soumame/namecard/THIRD_PARTY_NOTICES.md

# Third-party notices

このリポジトリで独自に作成したハードウェア設計、製造データ、ファームウェア、Android・iOSアプリ、文書は、ルートの[MIT License](LICENSE)で提供します。

次の第三者著作物には、それぞれのファイルに含まれるライセンスが優先して適用されます。

## STMicroelectronics / Arm CMSIS

- `firmware/Drivers/STM32G0xx_HAL_Driver/` — STMicroelectronics BSD-3-Clause license (`LICENSE.md`)
- `firmware/Drivers/CMSIS/Device/ST/STM32G0xx/` — Apache License 2.0 (`LICENSE.md`)
- `firmware/Drivers/CMSIS/Core/` — Apache License 2.0 (`firmware/Drivers/CMSIS/LICENSE.txt`)

各ディレクトリ内の著作権表示およびライセンス表示を保持してください。

## Google Material Symbols

`client/android/app/src/main/res/drawable/ic_*.xml`のアイコン（独自作成の`ic_qr_code.xml`を除く）はGoogle Material Symbolsを元にしたAndroid Vector Drawableで、Apache License 2.0の対象です。

- Source: <https://github.com/google/material-design-icons>
- License: <https://www.apache.org/licenses/LICENSE-2.0>

## External dependencies

Androidアプリおよびファームウェアのビルド時に取得される外部依存関係は、それぞれの配布元ライセンスに従います。

### ZXing Core

- AndroidのQRコード生成に`com.google.zxing:core:3.5.4`を使用します。
- Source: <https://github.com/zxing/zxing/tree/zxing-3.5.4>
- License: Apache License 2.0。本文はAPK内の`assets/licenses/zxing-core.txt`に同梱します。
