soumame/namecard/firmware/docs/SOURCES.md

# Primary references and vendored components

- Good Display GDEY029T94 product/sample page:
  <https://www.good-display.com/product/386.html>
- GDEY029T94 / SSD1680 specification used for command table and timing:
  <https://www.laskakit.cz/user/related_files/gdey029t94.pdf>
- ST25DV04K datasheet, DS10925:
  <https://www.st.com/resource/en/datasheet/st25dv04k.pdf>
- ST25DVxxK errata ES0616 (FTM 256-byte read and watchdog workarounds):
  <https://www.st.com/resource/en/errata_sheet/es0616-st25dv04k-st25dv16k-and-st25dv64k-device-limitations-stmicroelectronics.pdf>
- AN4913, EH delivery impact during RF communication:
  <https://www.st.com/resource/en/application_note/an4913-energy-harvesting-delivery-impact-on-st25dvi2c-series-behaviour-during-rf-communication-stmicroelectronics.pdf>
- TPS22917 datasheet:
  <https://www.ti.com/lit/ds/symlink/tps22917.pdf>
- STM32G031x6 datasheet (pinout, PVD and BOR electrical characteristics):
  <https://www.st.com/resource/en/datasheet/stm32g031f6.pdf>

Vendored under `Drivers/`:

- STM32G0xx HAL Driver v1.4.7
- CMSIS Device G0 v1.4.5
- CMSIS Core(M) headers: `__CM_CMSIS_VERSION_MAIN=5`, `__CM_CMSIS_VERSION_SUB=3`
  in `Drivers/CMSIS/Core/Include/cmsis_version.h` (the header file revision is V5.0.3).

Each vendor subtree contains its upstream license. Application code in `Core/` is project code.
