soumame/namecard/production/README.md

# Production files

JLCPCBへ入稿するための製造データです。

- [`v5/`](v5/) — Maker Faire Tokyo 2026向けの現行版
- `v2/`〜`v4/` — 過去版の記録。新規発注には使用しないでください
- [`namecard_v5_production.zip`](namecard_v5_production.zip) — `v5/`の配布用パッケージ

発注時は在庫、部品価格、向き、基板プレビューをJLCPCBの画面で再確認してください。製造サービス側の在庫や仕様は変化する可能性があります。
