soumame/namecard/client/ios/README.md

# Namecard for iOS

iOS 17以降向けのSwiftUIアプリです。販売済みの名刺基板・FWを変更せず、
Androidと同じ296×128 BINを利用します。MameCardとしてTestFlightでベータ配布しています。

**[TestFlight事前登録フォーム](https://forms.gle/RqQPmfoJ9aMMtRm66)への回答後に、参加リンクをお送りします。**
届いたリンクからTestFlightの案内に沿ってインストールしてください。試験内容・報告方法は
[ベータ試験ガイド](docs/BETA_TESTING.md)を参照してください。App Store公開に向けた実機検証は継続中です。

以下の機能説明はリポジトリの現行ソースを対象とします。配布済みビルドの変更点はTestFlightの「テスト内容」を確認してください。

## 開発環境

- Xcode 26以降、Swift 6 toolchain（アプリの言語モードはSwift 5）。外部Swiftパッケージは不要です。
- iOS 26では標準のナビゲーションとコントロール、およびエディタの操作面にLiquid Glassを使用します。
  iOS 17〜18では同じ機能と階層を保った標準Material／Buttonスタイルへフォールバックします。
- `Namecard.xcodeproj`を開き、通常は`Namecard` schemeを使用します。
- SimulatorではNFC以外の編集・Library・ファイル機能を確認できます。
- 実機ではApple Developer ProgramのTeamとNear Field Communication Tag Readingを設定します。
  証明書の秘密鍵、プロビジョニングプロファイル、API鍵はリポジトリへ保存しません。

```sh
swift test --package-path client/ios/NamecardCore
python3 client/ios/tools/generate_project.py --check
xcodebuild -project client/ios/Namecard.xcodeproj -scheme Namecard \
  -destination 'generic/platform=iOS Simulator' CODE_SIGNING_ALLOWED=NO build
```

`python3 client/ios/tools/select_simulator.py`でインストール済みiPhoneのUDIDを取得し、
`-destination 'platform=iOS Simulator,id=<UDID>' test`でアプリ単体試験とUI試験を実行します。
文字の代替フォントは言語設定によって変わるため、CIのアプリ単体試験は
`-testLanguage en -testRegion US`を指定します。文字の選択枠を変更した場合は、
`-only-testing:NamecardTests/EditorTests`を英語設定と`-testLanguage ja -testRegion JP`の両方で確認してください。
UI試験はテスト内でアプリを日本語設定で起動します。
XcodeプロジェクトはPython標準ライブラリとmacOSの`plutil`を使う`tools/generate_project.py`から再生成でき、
同期グループによってSwiftファイルが自動的にターゲットへ入ります。
`--check`は書式やXML属性の順序ではなく設定内容を比較します。Team、署名方式・証明書指定・
プロファイル指定、Version／Build（SDK別の指定を含む）は再生成時にも保持します。
Bundle IDや機能フラグ等の変更は生成スクリプト側にも反映してください。

### SDKとSimulator Runtimeの不一致がある場合

インストール済みRuntimeでもschemeの実行先選択が拒否される環境では、最新ソースを
ターゲット指定でビルドし、生成済み成果物からプロジェクトに依存しない`.xctestrun`を作成できます。
`select_simulator.py`が出力する`NAMECARD_SIMULATOR_ID=...`をシェルに設定して実行します。

```sh
xcodebuild -project client/ios/Namecard.xcodeproj -target NamecardTests \
  -configuration Debug -sdk iphonesimulator CODE_SIGNING_ALLOWED=NO \
  SYMROOT=/tmp/namecard-products OBJROOT=/tmp/namecard-objects build
python3 client/ios/tools/make_simulator_test_run.py \
  --products /tmp/namecard-products/Debug-iphonesimulator \
  --output /tmp/namecard-tests.xctestrun
xcodebuild test-without-building -xctestrun /tmp/namecard-tests.xctestrun \
  -destination "platform=iOS Simulator,id=$NAMECARD_SIMULATOR_ID" \
  -parallel-testing-enabled NO
```

UI試験はビルド対象を`NamecardUITests`にし、生成ツールへ`--ui`を追加します。
ツールは選択中のXcodeと実際の`Info.plist`を読み、実行設定だけを生成します。
ビルド・Simulator起動・テスト実行・Runtimeダウンロードは行いません。

`actool`もRuntime不足で失敗する場合、切り分け用のターゲットビルドには
`EXCLUDED_SOURCE_FILE_NAMES=Assets.xcassets`を一時指定できます。その成果物によるテストは、
アセットを含む完全ビルドや配布用Archiveの検証には含めません。SDKに対応するRuntimeを
導入後、除外指定なしで検証してください。

## 機能

- **New:** 画像・日本語テキスト、テキスト追加時のフォント・太字／斜体／下線、移動／サイズ／回転、重なり、Undo／Redo、グリッド・位置スナップ、紙面表示の変換・表示回転スナップ。
- **Library:** 完成BIN保存、取込、名称変更、削除、書き出し、完成画像を1レイヤーとして再編集。
- **Settings:** 白黒クリーニング、10内蔵パターン、STATUS、端末内のコピー可能な通信ログ。
- **振動による位置案内（試作）:** SettingsでONにすると、表示書き込み中の既存ACKから電源・応答の安定を短い振動で案内します。初期OFF。手順とAndroid向けの検討は[触覚案内](docs/HAPTIC_FEEDBACK.md)を参照してください。
- **URL:** HTTP(S)のNDEF書込・URLクリア・読み返し・Mailbox復旧。既知の未フォーマットST25DV04Kにも対応します。
- **QRコード:** URLの隣のボタンから入力フォームを開き、生成プレビューを確認して名刺へ画像として追加できます。
- **BIN:** 白黒4,736 bytes、4階調9,472 bytes。ヘッダーなし、Androidと相互利用可能です。

4階調の作成・保存・BIN入出力は利用できますが、NFC書き込みは無効です。
現FWはEXECUTE後に60秒のRF無通信を要求し、Core NFCのセッション上限に収まりません。
4階調を黙って白黒へ変換しません。Androidで4階調表示した名刺から白黒へ戻す経路も、
独立したFull更新の給電検証が必要なため、現在は拒否します。

## QRコードの作成

Newの`URL`の隣の`QRコード`を押し、URL入力→`QRコードを生成`→プレビュー→`名刺に追加`の順で操作します。
生成画像は通常の画像レイヤーと同様に移動・拡縮・回転・重なり順変更・Undo／Redoでき、
Library・BIN・NFC画像書き込みにも含まれます。QR生成で名刺のNFC URLは変更されません。

HTTP(S)の検証・補完は既存のURL設定と共通です。生成は端末内の
[Core Image QRコード生成器](https://developer.apple.com/documentation/coreimage/ciqrcodegenerator)を利用します。
URL変更時は古いプレビューを消去し、再生成が必要になります。
白い余白を4セル以上確保し、初期配置は最大120×120ピクセル、1セル2ピクセル以上の整数倍率です。
これより細かい長いURLはプレビューのみ可能で、名刺へ追加するには短いURLが必要です。
実物では配置・縮小・回転・余白の重なり・電子ペーパーの状態によって読みやすさが変わるため、書き込み後も読み取れるか確認してください。

## テキストの書式と表示回転スナップ

Newの`テキスト`で文字を入力し、`B`（太字）・`I`（斜体）・`U`（下線）と`フォント`を設定して追加します。
初期値は従来どおりシステムフォント・太字です。フォントは検索でき、入力フォームのプレビュー、
紙面・完成画像・BINで共通の書式を使います。書式は拡縮・回転・Undo／Redoでも保持されます。
フォント一覧は公開APIの[UIFont.familyNames](https://developer.apple.com/documentation/uikit/uifont/familynames)と
`fontNames(forFamilyName:)`から取得するため、OSと端末により異なります。
太字の書体がない場合は、選んだフォントを保ったまま線幅を補います。
斜体は日本語の代替フォントにも反映できるよう、文字全体を傾けます。
そのフォントにない文字はOSの代替フォントで表示されます。

ツールバーの`表示回転スナップ`は、灰色の余白から操作する紙面表示の回転に適用されます。
初期OFFで、ONにすると15°ごとの角度に4°以内で吸着します。既存の要素の位置スナップとは独立しています。
ゆっくり回しても吸着から抜けられ、表示の拡縮・移動と同時に使えます。
表示回転・スナップ設定は完成画像やBINには含まれません。

`要素回転スナップ`は画像・テキストの回転に適用される独立トグルです。初期OFFで、
ONにすると紙面に対する要素の角度を15°間隔・±4°以内で吸着させます。
位置スナップ・表示回転スナップとは別に切り替えられ、移動・拡縮と同時に使用できます。
要素の回転は完成画像・BINにも反映され、1回のジェスチャーをUndo／Redoできます。

## 給電検証と公開制限

通常のDebug／Releaseは`Resources/HardwareValidation.json`に実測結果のある端末・OSだけ
表示書き込みを許可します。初期状態のリストは空です。編集・BIN・URL・STATUSは使用できます。
**テスト通過だけで実測リストを埋めないでください。**

`Namecard Hardware` schemeは実機で給電を測定するための専用ビルドです。
通常／一括／旧FWの更新時間に仮の8／20／8秒を使います。計測値ではありません。
4階調書込と4階調からの移行はこのschemeでも無効です。
上記2つのschemeのArchiveはReleaseを使用します。

`Namecard Beta` schemeをTestFlight試験用に追加しています。最適化したBeta構成でArchiveし、
画面には「ベータ試験版」と表示します。現在はiOS 17以降のNFC対応iPhoneで白黒書き込みを試せます。
時間予算は同じ仮の8／20／8秒で、実測済みとは扱いません。通常Releaseの検証済み端末リストは空のまま維持します。
試験対象の設定と報告内容は[ベータ試験](docs/BETA_TESTING.md)を参照してください。
Betaでも4階調書き込み・未検証の4階調からの移行は無効です。

詳細は[実機試験](docs/HARDWARE_VALIDATION.md)と[配布手順](docs/DISTRIBUTION.md)を参照してください。
自動テスト・Archiveの結果と実機での未確認事項は[検証記録](docs/VALIDATION.md)に記載しています。
PR #4（@fromkk）から取り込んだLibraryサムネイルの改善と、ほかの差分の採用判断は
[選択統合の記録](docs/PR4_INTEGRATION.md)を参照してください。

## 通信と復旧

ST25の通常速度MailboxコマンドをCore NFCの`customCommand`へ渡します。
DATAは128 bytes、ACKは32 bytes。NC v1とCRC、応答の識別・転送位置を検証します。
Mailboxの空き／ACK確認は50ms間隔です。DATAの一時エラー・ACK喪失は、残り時間を確認し、
同じフレームを最大3回（初回を含む）まで送信します。遅れて届いた一致するACKも検証して回収します。
副作用のないMB_CTRL（ST25 AD）読み取りは、一時的なRF応答エラーに限り100／200ms待って最大3回試します。
接続喪失・設定エラーはこの読取再試行の対象外です。Mailboxの内容を消費する読み取りや書き込みには適用しません。
画像転送の起動・COMMIT後は1.5秒、EXECUTE後はFWのquiet指定以上、RFコマンドを止めます。
実測した更新上限＋5秒をセッション内に確保できなければ、EXECUTE前に再スキャンを案内します。

画像とACK進捗はRAMに保持し、同じUIDだけに再開します。アプリ終了後は再度画像を選択します。
START／DATA中の接続喪失では、有効なセッション内で最大6回、同じUIDのタグを再検出します。
元の60秒期限は延長せず、MCUのRAMが失われていれば画像を最初から転送します。
COMMIT以降にはこの再検出を行いません。OSがセッションを終了した場合や復旧回数を使い切った場合は、
画面から同じ名刺を再スキャンしてください。通信ログには端末識別子・OS・コマンド・ACK位置・VDD・残り秒数を残します。
EXECUTE送信後のACK喪失時は、アプリ側から電界を切らずOSのセッション終了を待ちます。
EXECUTE ACKとquiet待機後の完了確認で、一時的な通信エラー・破損フレームが出た場合は、同じ接続でSTATUSだけを
最大3回（初回を含む）確認します。quietと元の更新時間上限・セッション期限を守り、更新命令は追加しません。
接続喪失や位置不一致はこの再試行の対象外です。確認できなければ、表示は更新済みの可能性がある旨と未確認の理由を表示します。
再接続のSTATUS COMPLETEだけでは目的の画像と断定せず、安全に再転送します。
セッション終了時はCore NFCの遅れた応答を待たずにアプリ側の通信処理をキャンセルし、
後から届く応答は破棄します。転送状態の後始末が終わると、画面から再スキャンできます。
終了後は最低1秒、Core NFCが使用中（Code 203）の場合は2／4／6秒の待機を設け、再スキャンの連打を防ぎます。
この待機はアプリ側の対策であり、OSのNFCリソース解放を保証する時間ではありません。
COMMIT応答の喪失後に本体がCHARGING／READYを返した場合、STATUSだけで対象画像を判断せず、
元画像とUIDを保持して新しいTransfer IDでSTARTから清掃付き再転送します。
EXECUTE前に転送位置の矛盾を検出した場合も、次のスキャンに矛盾した再開位置を持ち越しません。

NFCシステムシートの通常の進捗表示は最大毎秒1回とし、段階変更・エラー・完了はすぐ反映します。
アプリの通常進捗は最大毎秒4回です。NFCの画面を独立させ、進捗でエディター・Library全体を再描画しません。
通信ログは引き続き全イベントを記録し、通信中は全文のライブ描画を止めます。コピーでは記録済みの全文を取得できます。

Newの`URL`画面で`URLをクリア`を選び、名刺へタッチすると、URLを空のNDEFレコード
（`TNF_EMPTY`、`D0 00 00`）へ置き換えます。URL入力は不要です。空欄の通常書き込みは
従来どおり拒否します。クリア後は通常タッチで開くURLがなくなり、画像更新とURLの再設定は可能です。
NFCタグ自体の検出やロック設定は変更しません。既存のURL書き込み対応FWをそのまま利用します。
背景読取りはURIレコードを対象とします（[Appleの仕様](https://developer.apple.com/documentation/corenfc/adding-support-for-background-tag-reading)）。

URLの設定・クリアはPREPARE応答後だけMailboxを停止します。URL復旧記録をApplication Supportへ原子的に保存し、
未フォーマット品はCC／長さ0／本体／最終長の順に更新します。
中断後の同じUIDで書き込み予定と一致する場合だけ復旧し、未知データや保護領域は初期化しません。
静的MB_MODE、EH_MODE、パスワード、FW、基板は変更しません。

URL処理は最初に4秒RFコマンドを止め、その後は最大8秒、VCC_ONとMailboxの起動を確認します。
通常の上書きでは全メモリの事前読出しを省き、読み返しはCC／TLVを解析してNDEF末尾までに限定します。
未フォーマット品と初期化途中の復旧では、従来どおり512 bytes全体と保護状態を検証します。
副作用のないURL読出しの一時エラーは100／200ms待って最大3回試します。書込・ACK読出しはその場で再送しません。
接続喪失時は同じUIDを最大3回再検出し、元の60秒期限に14秒を超える余裕がある場合だけ自動復旧します。
再接続時に通常のNDEF領域が既に目的の内容なら再書込を省き、読み返しとMailbox再開を確認して完了します。
URLの処理段階、読出しブロック、一時エラーの再試行、再検出はSettingsの通信ログで確認できます。

クリア中断時も操作の種類とUIDを復旧記録へ保存します。アプリ再起動後はSettingsの
`URLクリアを再開`から同じ名刺で再開できます。未完了のURL設定をクリア操作で置き換えることはできません。
旧バージョンのURL設定の復旧記録も引き続き再開できます。

## 保存とプライバシー

Libraryはアプリ内にBIN＋JSONを保存します。編集レイヤーとUndo／Redo、クリーニング設定は
起動中だけ保持します。LibraryとURL復旧記録はOSバックアップに含まれる場合があります。

振動による位置案内のON／OFFは端末内に保存し、次回起動時にも維持します。
ユーザー操作によるFilesへの書き出し先にはiCloud等も選択できます。
[プライバシーポリシー](docs/PRIVACY.md)を参照してください。
