soumame/namecard/client/ios/docs/PRIVACY.md

# Namecard iOS プライバシーポリシー

Namecardは、名刺基板の画像とURLを編集・書き換えるアプリです。

画像、入力したテキスト、URL、名刺の識別子と通信ログは端末内で処理します。
開発者のサーバーへの送信、広告、利用状況解析、アカウント登録はありません。
写真はシステムの選択画面でユーザーが選んだものだけを読み込みます。

Libraryの完成画像と名称、未完了のURL書き込みを復旧するための記録は、
アプリ内ストレージへ保存します。これらはiOSの端末バックアップに含まれる場合があります。
振動による位置案内のON／OFFも、アプリ専用の設定として端末内へ保存します。
編集中のレイヤー、Undo履歴、画像の転送進捗、通信ログは起動中のメモリで保持します。
Libraryの画像はアプリ内で削除できます。アプリを削除するとアプリ内データも削除されます。

ユーザーがファイルを書き出したり、ログをコピーしたりした場合、選択した保存先・共有先の
サービスへ内容が渡ることがあります。URLには個人情報を含めないよう、共有する内容をご確認ください。
名刺基板へ書き込んだ画像とURLは名刺を持つ人・読み取る人が閲覧できます。

お問い合わせは[プロジェクトのIssues](https://github.com/soumame/namecard/issues)で受け付けます。
公開Issueには個人情報を含む画像・URL・ログを投稿しないでください。
