soumame/namecard/production/v5/namecard_v5_bom.xlsx

Sheet: BOM
Designator | Footprint | Quantity | Value | LCSC Part #
C1, C10, C11, C12, C2, C5, C6, C7, C9 | 0603 | 9 | 1uF 50V X5R | C15849
C3 | 0805 | 1 | 4.7uF 25V X5R | C722528
C4 | 0603 | 1 | 4.7uF 16V X5R | C19666
C13, C8, C47, C18, C20 | 0603 | 5 | 100nF | C14663
C19 | 0603 | 1 | 1nF | C1588
C23, C25 | 0805 | 2 | 1uF | C28323
C24, C26 | 0805 | 2 | 100nF | C28233
C27 | 0402 | 1 | 1nF | C1523
C28, C41, C43, C44, C45 | 0402 | 5 | 100nF | C1525
C29, C30, C31, C32, C42 | 0805 | 5 | 22uF 6.3V X5R | C5674
C40 | 0805 | 1 | 10uF 25V X5R | C5137488
C46, C48, C49, C14, C15, C16, C17, C39 | CP_EIA-3528-21_Kemet-B | 8 | 220uF 6.3V | C30242
D1, D2, D3 | D_SOD-123 | 3 | MBR0530T1G | C82046
D5, D6 | D_SOD-123 | 2 | 1N4148W | C47117477
J1 | Hirose_FH12-24S-0.5SH_1x24-1MP_P0.50mm_Horizontal | 1 | Conn_01x24 | C506794
L1 | L_APV_ANR4020 | 1 | 47uH | C167813
L2 | L_Sunlord_SWPA252012S | 1 | 2.2uH | C23894
Q1 | SOT-23 | 1 | AO3400A | C20917
R1 | 0603 | 1 | 1M | C22935
R2 | 0603 | 1 | 2.2R | C22939
R7 | 0402 | 1 | 4.7M | C3013173
R8 | 0402 | 1 | 1k | C11702
R9 | 0402 | 1 | 36.5k 1% | C25887
R10 | 0402 | 1 | 5.11k 1% (2.5mA) | C274895
R11 | 0402 | 1 | 16.2k 1% | C27176
R12 | 0402 | 1 | 0R | C17168
R13, R4, R6 | 0603 | 3 | 10k | C25804
R14 | 0603 | 1 | 1k EPD DISCHARGE | C21190
U1 | LQFP-32_7x7mm_P0.8mm | 1 | STM32G031K8T6 | C432203
U2 | DFN-8-1EP_3x2mm_P0.5mm_EP1.36x1.46mm | 1 | ST25DV04K-IER6C3 | C2908287
U3, U4 | SOT-23-6 | 2 | TPS22917DBV | C2681320
U5 | SOT-23 | 1 | TPS3839K33DBZR | C96333
U6 | SOT-363_SC-70-6 | 1 | LM66100 | C2869734
U7 | WSON-10-1EP_2.5x2.5mm_P0.5mm_EP1.2x2mm_ThermalVias | 1 | TPS63900 | C1518762

Sheet: Source
Source | JLCPCB purchased-parts export for the 30-board v5 order
Original file | jlcpcb_purchased_parts_30pcs.xls
Original SHA-256 | 9db658aa72fdb9226f612281968298a40f6ec9856aafbc009097e5e60bace6b8
Export date | 2026-09-04
Normalization | Quantity is the number of listed designators per board; purchase quantities and prices remain in the original XLS.
Assembly scope | 69 JLCPCB-assembled placements. J2 is not in the purchased-parts export and is excluded from this BOM/CPL.
JLCPCB format reference | https://jlcpcb.com/help/article/how-to-generate-the-bom-and-centroid-file-from-kicad
