soumame/namecard/client/ios/docs/HARDWARE_VALIDATION.md

# iPhone実機検証

この資料の連続成功・計測条件はApp Store公開用です。TestFlightの協力者向け試験は
[ベータ試験](BETA_TESTING.md)のBeta構成を使い、仮の時間予算と実測結果を分けて扱います。

2026-09-14、URL書き込みでiOSは`isAvailable=false`、Androidは1回で成功したとの報告を受けました。
今回の端末・OS・URL・失敗段階・ログの時刻対応は未取得です。iOSの起動確認、読出し量削減、
一時読出しエラーの再試行、同一UIDの自動再検出を追加しましたが、修正後の実機RF試験は未実施です。
同じURL・同じ名刺で設定→クリア→再設定を確認し、途中切断では別UIDへの書込を拒否し、
再接続後に読み返しとMailbox再開まで完了すること、Settingsに失敗段階が残ることを確認してください。

状態: **転送・再接続が改善し、最新報告では当て方による不調・切断は残るが処理のスタックは見られない。連続書き込みの完了確認警告が解消したかは未確認。給電計測は未実施**。
2026-09-07、ユーザーからアプリのビルド・起動・STATUS表示、その後チェック柄の書き換えが動作したとの報告を受けました。
作成画像は転送の半分より前、毎回異なるバイト位置で止まり、Core NFCの
`NFCError Code=100 "Tag connection lost"`が記録されています。固定の4,096-byte境界での停止ではありません。
通信復旧修正後の再試験では、1回目は約4,000 bytes送信した直後に「送信内容の不一致」とのエラー、
2回目は作成画像の更新に成功したとの報告を受けました。正確な表示文言とACKログは未取得です。
1回目がDATA／COMMIT／EXECUTE後のどの段階だったか、2回目が再開操作か新規書き込みかは未確認です。
追加報告では、失敗時のSettingsログは残っていません。Core NFCコンソールにはCode 100と
`setAlertMessage`の行が繰り返し出ており、ユーザーは切断後も動作を継続できていると確認しています。
このコンソール断片にはNCコマンド・ACK・時刻がないため、再検出の回数やCOMMIT前後の切断とは特定しません。
「書き換え直前に切れると失敗する」という原因の推測は、未確認の仮説として扱います。
その後も複数回書き込みを行い、Code 100が時々発生し、再度操作すると成功することを繰り返したとの報告があります。
URL書き込みとクリーニングも動作確認済みです。URLの初期フォーマット状態、清掃の一括／旧FW方式、
正確な成功・失敗回数、各段階のACKログは未取得です。Androidより転送が遅く感じるとの申告もあり、時間計測は未実施です。
2026-09-08、ユーザーからiPhone XRのOSは**iOS 18**との訂正を受けました。
使用機種はAndroidがPixel 9 Pro／POCO X3 NFC、iOSがiPhone XRです。実機のmodel identifierとOSログは未取得です。
Androidの2機種でも、現在の通信設定で体感3〜4回の切断・復帰を経て成功するとの追加報告があります。
これは正確な再接続回数の計測ではなく、Androidを無切断で成功する基準端末とは扱いません。
両OS、特にAndroidで、ホーム画面へ戻るかアプリを終了するまで再接続できなくなるとの報告もあります。
Androidではその後、正常終了後の次の書き込みで反応しない／URLが開く問題に対して探索再初期化を追加し、
ユーザーから改善したとの報告を受けました（2026-09-08、確認端末・試行回数は未記録）。
iOSの再検出上限6回・キャンセル処理の追加修正後、3試行で失敗したとの報告を受けました。
1回目は約1秒ごとの切断と再試行後、送信完了直後に`isAvailable=false`、再スキャン後は転送位置の不一致で継続不能。
2回目は`ST25 AD NFCError(102) ISO15693=0f`、再スキャン後は同じ不一致、3回目も同様の結果との申告です。
コンソールにはCode 100、Code 203（System resource unavailable）、`setAlertMessage`と
デバッガー接続下の0.52／1.34／1.73秒のHang検出があります。アプリ内TX・ACKログと時刻対応は未取得です。
このため「送信完了」が最終DATA ACK／COMMIT／保存完了のどれだったかはまだ特定できません。
その後の再開不能・レジスタ読取・セッション待機・画面負荷の対策後、ユーザーから
「前回よりはるかによく動作」「切断が原因で中断することなく、復帰もうまくいく」との報告を受けました（2026-09-08）。
ただし連続2回目の書き込みでは、実際の表示更新後に完了確認が未完了というメッセージが出ています。
この報告は切断そのものがなくなったという意味には扱いません。複数の対策を同時に加えたため、改善への寄与も未分離です。
最新のエラー本文・ACK・経過時間・清掃設定・FW識別情報は未取得で、完了応答の喪失か時間不足かは未特定です。
完了確認対策の案内後、さらに「くっつけるとうまく動かなかったり切断されるが、処理がスタックする事態はなさそう」
との報告を受けました。同じ最新ビルドでの試験か、完了確認警告が再発したか、当て方と成功率の対応は未記録です。
実行scheme・ACK本文は未記録です。初期の修正直後は2試行中1成功で、その後の追加試行の正確な回数は不明です。
各経路の10回連続成功は未確認です。この報告だけで表示更新の検証済み端末へ追加しません。
自動テスト・Simulatorで給電成功を証明することはできません。
販売済みと同じ基板／FW／EPD／接着材／カバーを使用し、FWを書き換えずに試験します。

## 使用端末と公開資料で分かる範囲

| 端末（ユーザー申告） | 公開資料・現実装で確認できること | 実測・確認が残ること |
|---|---|---|
| Pixel 9 Pro | GoogleがNFC搭載とNFC位置の図を公開。公開caiman設定はSTのNFCサービスを使用。Android版はNfcVを使用 | NFC ICの正確な型番・実端末のOS・maxTransceiveLength・DATAサイズ・VDD・成功率 |
| POCO X3 NFC | Xiaomi公式仕様にNFC搭載を明記。Android版は同じNfcVのコード経路を使用 | NFC ICの正確な型番・最適固定位置・OS・実DATAサイズ・VDD・成功率 |
| iPhone XR（iOS 18との訂正申告） | Apple公式仕様でNFC reader mode対応。iFixitの実分解ではNXP SN100Vを同定。iOS版はCore NFCを使用 | 名刺へ供給できる電力・最適位置・転送時間・成功率 |

資料: [Pixelの仕様](https://support.google.com/pixelphone/answer/7158570?hl=en)、
[PixelのNFC位置図](https://support.google.com/pixelphone/answer/7157629?hl=en)、
[POCO X3 NFCの仕様](https://www.po.co/global/poco-x3-nfc/specs/)、
[iPhone XRの仕様](https://support.apple.com/en-ie/111868)、
[iFixitのXR実分解](https://www.ifixit.com/Teardown/iPhone%2BXR%2BTeardown/114123)。
Pixel 9 Proとcaimanの対応は[Googleのドライバー一覧](https://developers.google.com/android/drivers#caiman)で確認し、
STサービスは[Google公開の端末設定](https://android.googlesource.com/device/google/caimito/%2B/refs/tags/android-platform-15.0.0_r4/device-caiman.mk)で確認しています。
ソフトウェア構成からNFC ICの厳密な型番や名刺への出力を断定しません。

STの[AN5233](https://www.st.com/resource/en/application_note/dm00545186-energy-harvesting-with-st25dvi2c-series-dynamic-nfc-tags-stmicroelectronics.pdf)は、
スマートフォンのNFCコントローラー、アンテナの大きさ・位置・距離が取得できる電力に影響すると説明しています。
NFC搭載の有無やCPU世代だけで、この名刺に対する給電能力を順位付けしません。
3機種の比較ではアプリ側のDATA長と待機設定の差もあるため、今回の結果をそのままハードウェア性能差と扱いません。

## 記録する条件

- iPhone製品名、hardware model identifier、OSバージョン、ケースと固定位置。
- 基板版、出荷FWの識別情報、受信capability、パネル／カバー構成。
- セッション開始から検出、COMMIT、READY、EXECUTE ACK、COMPLETEまでの時刻。
- 無通信時の電界維持時間、OSのセッション失効、SYS_VDDとEPD_SW波形、最低VDD。
- 正常更新／一括クリーニング／旧FWクリーニングのEXECUTE以降の最大所要時間。

ST25DV04K→LM66100→TPS63900→VRES→SYS_VDDで給電します。現行回路図のVRESは約1.65mFです。
`simulation`の旧容量による表は検証結果として使用しません。
充電目標3.20V、EPD更新開始2.80V以上を確認します。
測定・外部電源は既存のfirmware/docs/HARDWARE_GATE.mdの手順に従ってください。

## 試験表

下表の各公開対象を、最小対応OS機と現行OS機を含む2機種以上で各10回連続成功させます。
対応しない経路を成功扱いにせず、プロファイルでは無効のままにします。

| 操作 | 結果 | 確認内容 |
|---|---|---|
| STATUS | 表示まで確認（ユーザー申告、2026-09-07） | ACK本文、VDD、FW error、capability、UID、機種・OS・試行回数の記録は未取得 |
| 作成画像（清掃設定未確認） | 修正後の1回目は約4,000 bytes後に不一致エラー、2回目は更新成功（ユーザー申告） | 清掃設定、正確なエラー、最後のACK、操作が新規か再開か |
| 作成画像の繰り返し書き込み | 最新修正後は転送・復帰が改善。連続2回目は表示更新済みだが完了確認が未完了 | 最終STATUS・EXECUTE ACK、残り時間、清掃設定、成功率 |
| クリーニング（方式未確認） | 動作確認済み（ユーザー申告） | 一括／旧FW方式、最後の画像、最低VDD、時間 |
| 白黒・清掃OFF | 清掃OFFと特定できる記録は未取得 | 本画像、ゴースト、最低VDD、COMPLETE |
| 白黒・FW一括清掃 | 一括清掃と特定できる記録は未取得 | 白→黒→白→本画像、再充電、時間上限 |
| 旧FWの清掃 | 未実施 | PATTERN4→3→4→画像、セッションまたぎ |
| 10内蔵パターン | チェック柄のみ更新成功報告。10種・連続試験は未実施 | 単独と連続、完了番号から再開 |
| DATA中の切断 | 最新修正後は切断による中断がなく復帰できるとの報告。回数と処理経路はログ未確認 | MCU保持／電源断、重複ACK・STARTから再送 |
| Flash保存後の切断 | 未実施 | PREPAREDから回復、以前のCOMPLETEを誤認しない |
| EXECUTE前後の切断 | 未実施 | ACK喪失、途中更新から同じ画像へ回復 |
| 時間不足・アプリ背景化 | 未実施 | 新セッションでの再開、更新中に自発的な時間切断をしない |
| URL既存／工場初期状態 | URL書き込みの動作確認済み。初期状態は未確認 | 書込・raw読み返し・Mailbox再開・通常タッチでURL |
| URL中断・再起動 | 未実施 | 同じUIDの復旧、未知変更の拒否、URL後の画像転送 |
| URLクリア | 未実施 | URL設定→クリア→通常タッチでURLが開かない→画像更新→URL再設定。Android／iOS双方で確認 |
| URLクリア中断・再起動 | 未実施 | クリア中の切断後に同じUIDで復旧。iOSはアプリ再起動後もSettingsから再開。クリア済み名刺の再クリアも確認 |
| QRコード画像 | 未実施 | QR生成→名刺へ追加→画像書き込み→Android／iPhoneのカメラで元URLを開けること。再配置・Library再読込後も確認 |
| AndroidとBIN往復 | 未実施 | 同一BINを両クライアントで表示・書込 |
| 4階調表示／pending→白黒・PATTERN | 未実施・無効 | Full白更新を含む電力・時間・中断復旧の独立検証 |

4階調移行は現ビルドで無効です。計測用に有効化するときだけ、TransferCoordinatorへ明示的な
grayTransitionRefreshSecondsを設定し、初版の公開プロファイルへ自動追加しないでください。
4階調そのもののNFC書き込みは今回の公開範囲に含めません。

## DATA転送の接続喪失を再試験する手順

1. `Namecard Hardware` schemeで最新コードを実機へ入れ、Settingsの通信ログを消去します。
2. 同じ白黒画像を選び、iPhone上端と名刺のアンテナの位置を固定して書き込みます。
   清掃ON／OFF、ケースの有無、固定位置も記録します。画像の絵柄を小さくしてもBINは4,736 bytesのままです。
3. 成否にかかわらずSettingsのログを保存します。端末・OS、最後のACK位置、VDD／最低VDD、
   失敗したST25コマンドとエラー、残り時間、DATA再送／UID再検出の有無を確認します。
4. 接続が取り直された場合は、同じ画像を最後まで更新できるか、RAM喪失後にSTARTから再送されるかを確認します。
   再検出後も元の60秒期限を守り、COMMIT以降や表示更新中に再検出しないことを確認します。
5. DATA中に3〜4回の切断・復帰を試し、ホーム画面への移動やアプリ終了なしで継続できるか確認します。
   iOSでセッションが終了した場合は、アプリの再開操作で新しいNFCシートを開けるか確認します。
   AndroidはReader Mode再初期化後に検出できるか、復旧中にURLから別アプリが開かないかも確認します。

修正ではDATAの限定的な再送、50msのMailbox確認間隔、START／DATA中だけのUID再検出を追加しました。
修正後に画像更新は成功していますが、安定性の検証と不一致エラーの原因特定は未完了です。Code 100だけで給電不足と断定せず、
ST25のRF／I2C競合も候補として、ACKログと電圧波形を照合してください。
[STの同種エラーに関する説明](https://community.st.com/t5/st25-nfc-rfid-tags-and-readers/how-to-realize-gt-gt-poll-lt-lt-cycle-as-described-in-an4910-in/td-p/606400)、
[AppleのrestartPolling仕様](https://developer.apple.com/documentation/corenfc/nfctagreadersession/restartpolling())を参照しています。

2026-09-08の追加修正では、iOSの同一セッション内の再検出上限を2回から6回へ増やしました。
Core NFCの接続開始時の接続喪失も復旧対象とし、セッション終了後は遅れたSDK応答を待たずに
アプリ側の処理をキャンセルします。元の60秒期限、同一UID、START／DATA限定の条件は維持しています。
Androidでは古い接続・転送処理が終了した後にReader Modeを300msの間隔で停止・再開し、
URL用接続を含むキャンセル処理と古い検出通知の排除を追加しました。
Androidは後続の連続書き込み修正後に改善報告を受けています。
iOSの実機では上記の再開不能が再発し、追加の調査・修正を行いました。

## 再開不能・Code 102／203・画面負荷の追加対策（2026-09-08）

FWの`app.c`ではpending画像をFlashから復元する際にID・次sequenceを復元しますが、
`nc_protocol.c`の重複フレーム判定用キャッシュは復元しません。
COMMIT受信後にACKを失い、その後に再起動した場合を模擬すると、修正前のiOSでも
転送位置の不一致を再現できました。実機の3試行すべてがこの経路だったとはまだ断定しません。

- COMMIT未確認のままCHARGING／READYへ再接続したら、保持した画像を新しいIDでSTARTから清掃付きで再送します。
- EXECUTE前の矛盾した再開位置は破棄し、元画像とUIDを保持します。ACK検証を緩めたり、STATUSだけで完了にはしません。
- ST25 ADの副作用のないレジスタ読み取りだけ、一時エラー時に100／200ms待って再試行します（最大3回）。
- 終了後に最低1秒、Code 203時は2／4／6秒待ち、終了処理と待機が終わるまで再開ボタンを出しません。
  OSのリソース解放を保証する時間ではなく、連打による再開始要求を抑えるアプリ側の設定です。
- システムシートの通常進捗を毎秒1回、アプリ進捗を毎秒4回までに抑えます。通信ログの全文描画を通信中は止め、
  NFC表示の更新がエディター・Library全体へ伝わらないようViewを分離しました。ログの記録・コピーは継続します。

[AppleのSystemIsBusyの説明](https://developer.apple.com/documentation/corenfc/nfcreadererror-swift.struct/code/readersessioninvalidationerrorsystemisbusy)、
[応答性改善の指針](https://developer.apple.com/documentation/xcode/improving-app-responsiveness)も参照しました。
Hang行だけからNFC切断の原因とは決めつけず、必要なら実機InstrumentsでMain Threadの停止箇所を確認します。
追加修正後、転送・復帰の改善報告を受けました。毎秒の切断の有無や各対策の寄与はログで分けて評価します。

「FW応答の転送位置が送信内容と一致しません」というアプリの文言は、
`TransferError.inconsistentAcknowledgement`です。コマンドとの対応、復旧時のsequence／offset、
表示更新後のSTATUSの位置・状態を確認する複数箇所で使われています。
この文言だけで本体の再起動や画像CRC不一致とは判定できません。
次回は失敗前後のTX・ACKと成功時のログを保存し、整合性の検証条件は緩めずに原因を確認します。

## 表示更新後の完了確認（2026-09-08）

連続2回目の画像更新後にSTATUSの応答だけを失う模擬試験で、修正前の処理が完了確認を打ち切ることを再現しました。
これは実機で報告された最後のエラー原因を特定したものではありません。

- EXECUTE応答とquiet待機の後、STATUSの一時的な通信エラー・破損フレームは、同じ接続で最大3回（初回を含む）確認します。
- 再試行の前にもquiet指定を守り、元の更新時間上限とセッション期限に余裕がある場合だけ続けます。
- 実際の接続喪失・キャンセル・位置不一致はこの再試行の対象外です。更新命令の再送・タグ再検出・ACK検証の緩和は行いません。
- 確認できない場合は「表示は更新済みの可能性がありますが、完了応答を確認できません」と表示し、電界を意図的に切りません。
  Settingsには転送ID・EXECUTE応答の有無・最後のACK位置・quiet・残り秒数を記録します。

追加報告ではスタックは見られませんが、完了確認の修正自体の成否は未確認です。まず画像A→Bの連続2回で表示とアプリの完了表示を照合し、
確認保留が出た場合はNFCシート終了後にSettingsログの末尾を保存してください。

## 次に確認する順序

触覚案内の初回試作は書き込み中に振動しないとの報告を受けました。原因ログは未取得です。
Core Hapticsへの変更後、ユーザーから書き換え・振動とも正しく動作したとの報告を受けました。
試行回数・OFF／ONの時間比較・電圧ログは未取得で、公開条件の達成とは扱いません。初期OFFを維持します。
テキスト操作時などの約3秒のHangも報告され、[計測を追加して切り分け中](PERFORMANCE.md)です。
試す場合は[触覚案内の手順](HAPTIC_FEEDBACK.md)に従い、OFF／ONの成否と所要時間を分けて記録してください。

先に当て方を比較します。同じ名刺・画像・清掃設定で位置を少しずつ変え、候補2〜3か所を各3回試します。
試行中は位置を動かさず、ケース・向き・位置を記録します。安定する位置を決めてから以下の連続試験へ進みます。
接触させること自体を最適な条件とは仮定せず、配置による差とアプリの復旧可否を分けて記録します。

1. 見分けやすい白黒画像A／Bを交互に書き込み、まず清掃OFFで10回、続いて清掃ONで10回試します。
   毎回、アプリの完了表示と電子ペーパーの最新画像の両方を確認します。
   以前の画像が残ったまま完了扱いになっていないこと、清掃途中の白／黒で止まらないことを確認します。
2. 試行ごとに画像、清掃設定、成否、所要時間、自動復旧の有無、手動の再スキャン回数を記録し、
   成功時もSettingsのログをコピーします。手動でやり直した成功は、最初の試行の失敗と分けて記録します。
3. 通常書き込みが安定したら、DATA途中と「4,736 bytes送信後・充電中」に位置を外し、同じ名刺で再開を試します。
   最後まで新しい画像になるかを確認します。最初の確認では表示更新開始後は位置を保ちます。
   EXECUTE中の電源断復旧は、上記の基本経路を確認した後、試験表の独立した項目として実施します。
4. URL設定→画像更新→通常タッチで同じURLを開く流れを確認します。
   別の名刺がある場合は、中断した画像の再開時に別UIDを拒否することも確認します。
5. Androidで出力した白黒BINもiOSで書き込み、2機種目のiPhoneで同じ公開対象経路を確認します。
   4階調関連の無効設定は維持します。

4,736 bytesの送信完了後にも、画像検証・保存、充電、EXECUTE、表示更新、完了確認が残ります。
アプリのバイト数だけを成功判定に使いません。

## Androidとの速度比較（実コードの設定差）

| 項目 | iOS | Android |
|---|---|---|
| DATAペイロード | 初版計画どおり128 bytes固定 | `min(240, maxTransceiveLength - 28)` bytes |
| 白黒4,736 bytesのDATA回数（再送除外） | 37回 | 240 bytesで送れる端末なら20回 |
| 送信後の最初のACK確認まで | 50ms | 50ms |
| ACKがまだない場合の確認間隔 | 50ms | 15ms |
| Mailboxが空くまでの確認間隔 | 50ms | 10ms |
| VDDに応じたDATA間隔 | 50／200／500ms | 同じ閾値・間隔 |

iOSの128 bytesはアプリ側の選択であり、Core NFCの最大ペイロードを表すものではありません。
初期計画に固定値として入れた暫定設定で、3機種の仕様や128／240 bytesの比較試験を根拠にした選定記録はありません。
小さいフレームから初期検証する選択ではありますが、128 bytesの方が安定するという実測根拠は未取得です。
本体のMailboxは256 bytes、NCヘッダーは16 bytesなので、FWプロトコルのDATA上限は240 bytesです。
128 bytesを給電の安全基準やMCUのRAM上限と説明しません。送信回数が増えてセッションが長くなる不利益も評価します。
送信回数が増える分、ACK待ちと給電のための間隔も繰り返します。VDDが低い場合は各回の待ちが長くなり、
一時エラーの再送・再検出・RAM消失によるSTARTからの再送でさらに所要時間が延びます。
ACKが最初の確認で届いていれば、確認間隔50msと15msの差による追加待ちはありません。
設定差から遅くなる要因は確認できますが、実際の速度比と各要因の寄与は未計測です。

比較は同じ白黒BIN・同じ清掃設定で、STARTから最終DATA ACK、COMMITからREADY、EXECUTEからCOMPLETEを分けて測ります。
Androidの実DATAサイズ、両端末のVDD、自動復旧と手動やり直しも記録します。
Androidの上限は実際の[getMaxTransceiveLength()](https://developer.android.com/reference/android/nfc/tech/NfcV#getMaxTransceiveLength())で取得し、
既存ログの`maxTx`と`DATA payload`で確認します。Pixel／POCOがともに240 bytesだったとはまだ確定していません。
今回の比較では通信設定を変更していません。将来DATAサイズを増やす試験では、変更前後の成功率も比較し、
128-byte境界を前提にした再開処理・テストも合わせて見直します。FWのquiet指定や給電待機を速度だけのために短縮しません。

## 実測値の反映

測定完了後、レポートをこのディレクトリへ追加してHardwareValidation.jsonのdevicesへ
model、iOSMajor、evidence（client/iosからのレポート相対パス）、normalSeconds、
batchSeconds、legacySeconds、completedRunsを記録します。時間にはばらつきを含む実測上限を使います。
未検証の一括／旧FW経路は対応する値をnullにし、その経路だけ無効のままにします。
5秒の余裕はアプリが別途加えます。時間を収めるためにquiet指定を短縮しません。

```sh
python3 client/ios/tools/check_release_readiness.py
```

現時点では検証記録がないため、このチェックは意図どおり失敗します。
