soumame/namecard/snapshots/namecard_revb-konnect-final-verified_1786166593.pdf

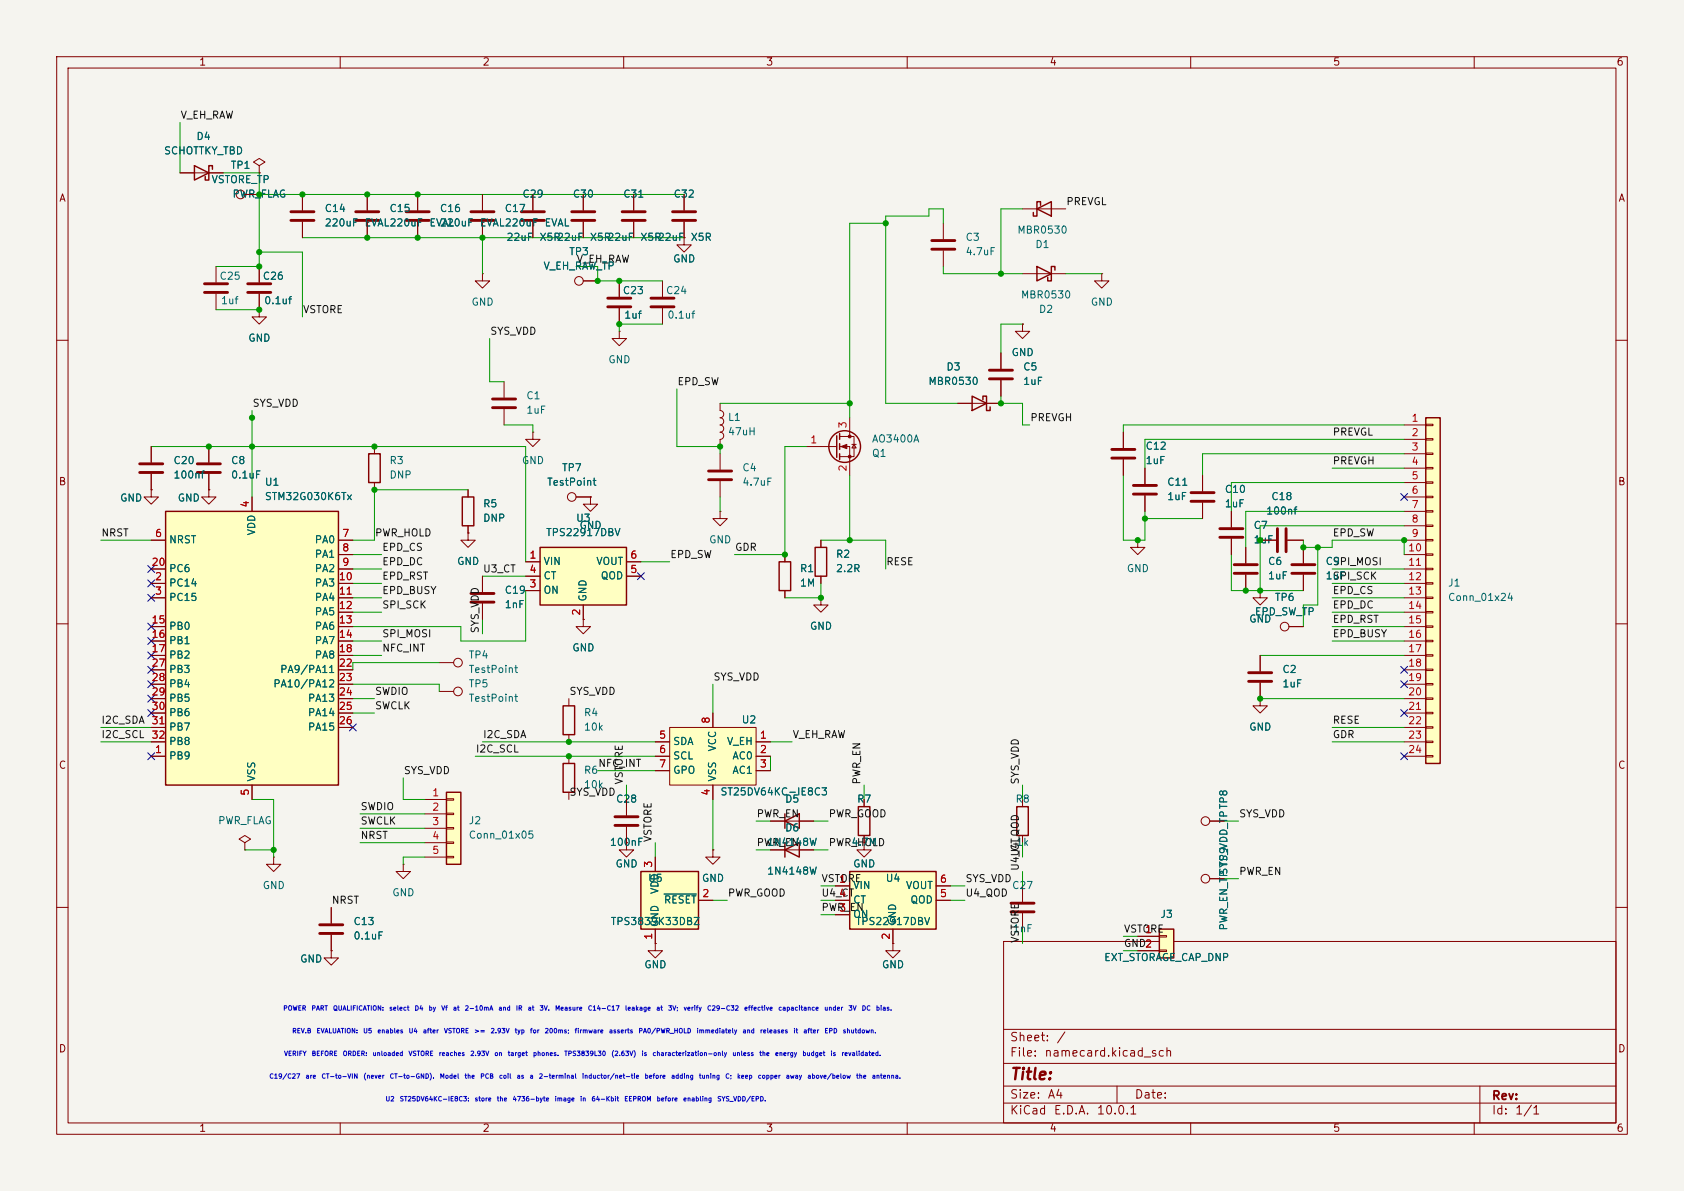
[picture p1: page 1]

Size: A4 | Rev:
KiCad E.D.A. 10.0.1 | Id: 1/1
