soumame/namecard/snapshots/namecard_revb-konnect-verified_1786166523.pdf

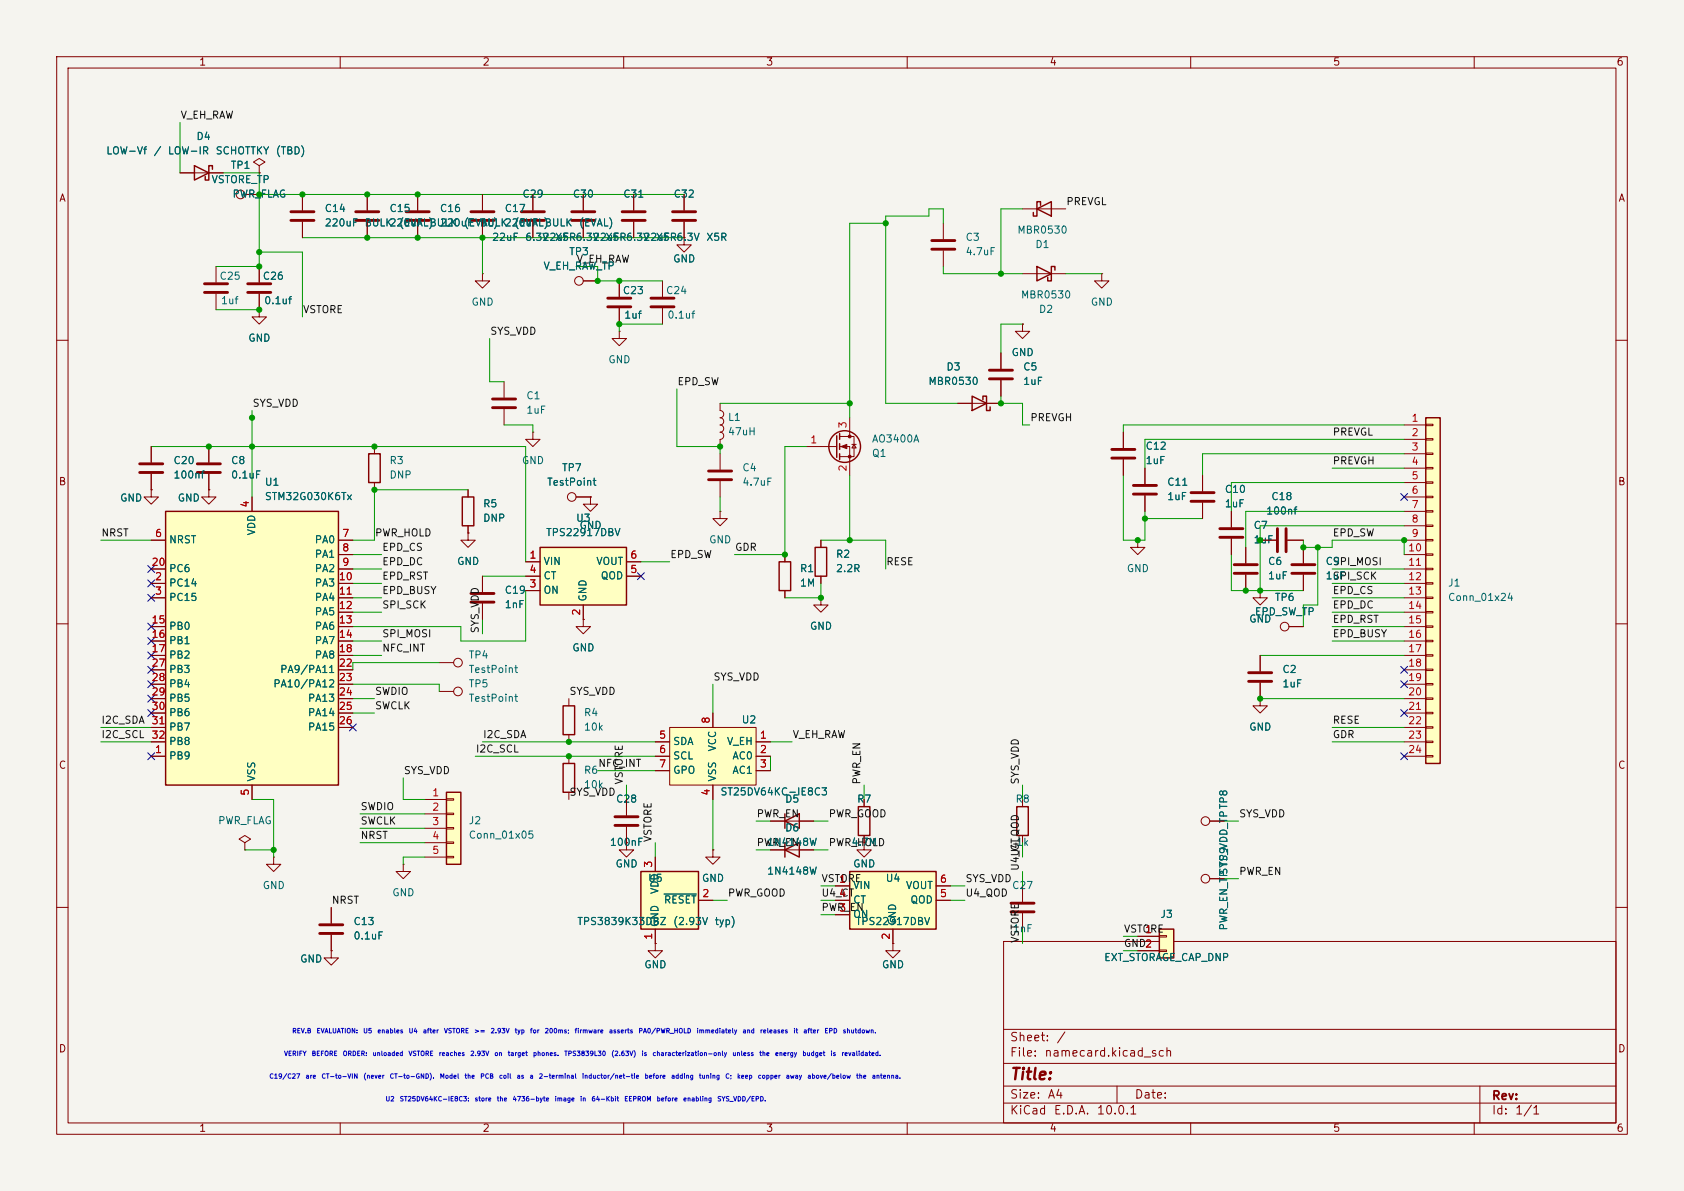
[picture p2: page 1]

LOW-Vf / LOW-IR SCHOTTKY (TBD) TP1

Size: A4 | Rev:
KiCad E.D.A. 10.0.1 | Id: 1/1
