soumame/namecard/snapshots/namecard_pcb_tps63900_added.pdf

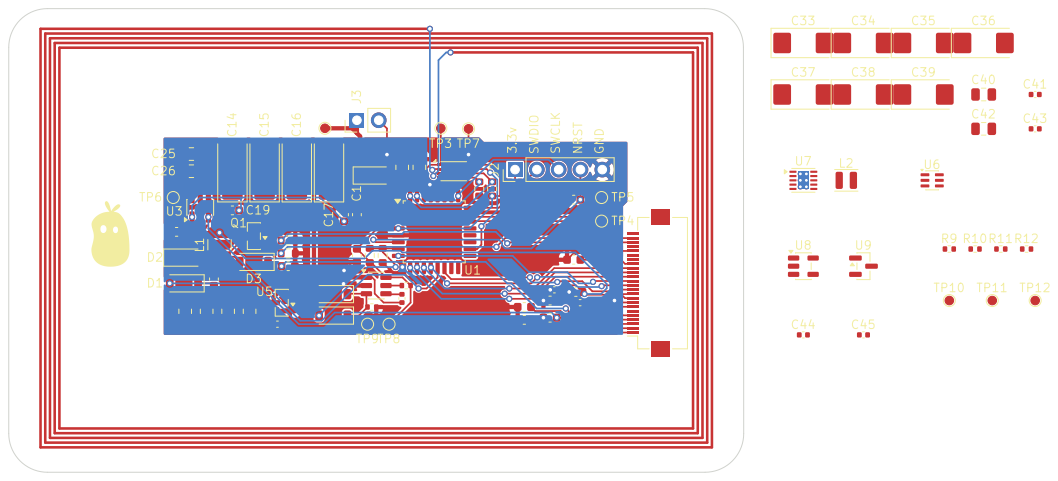
[picture p3: page 1]

3.3v SWDIO SWCLK NRST GND TP3 C34 C40 C41 C15 R10 C45 D1 C14
