soumame/namecard/snapshots/namecard_pre-revb-konnect_1786165618.pdf

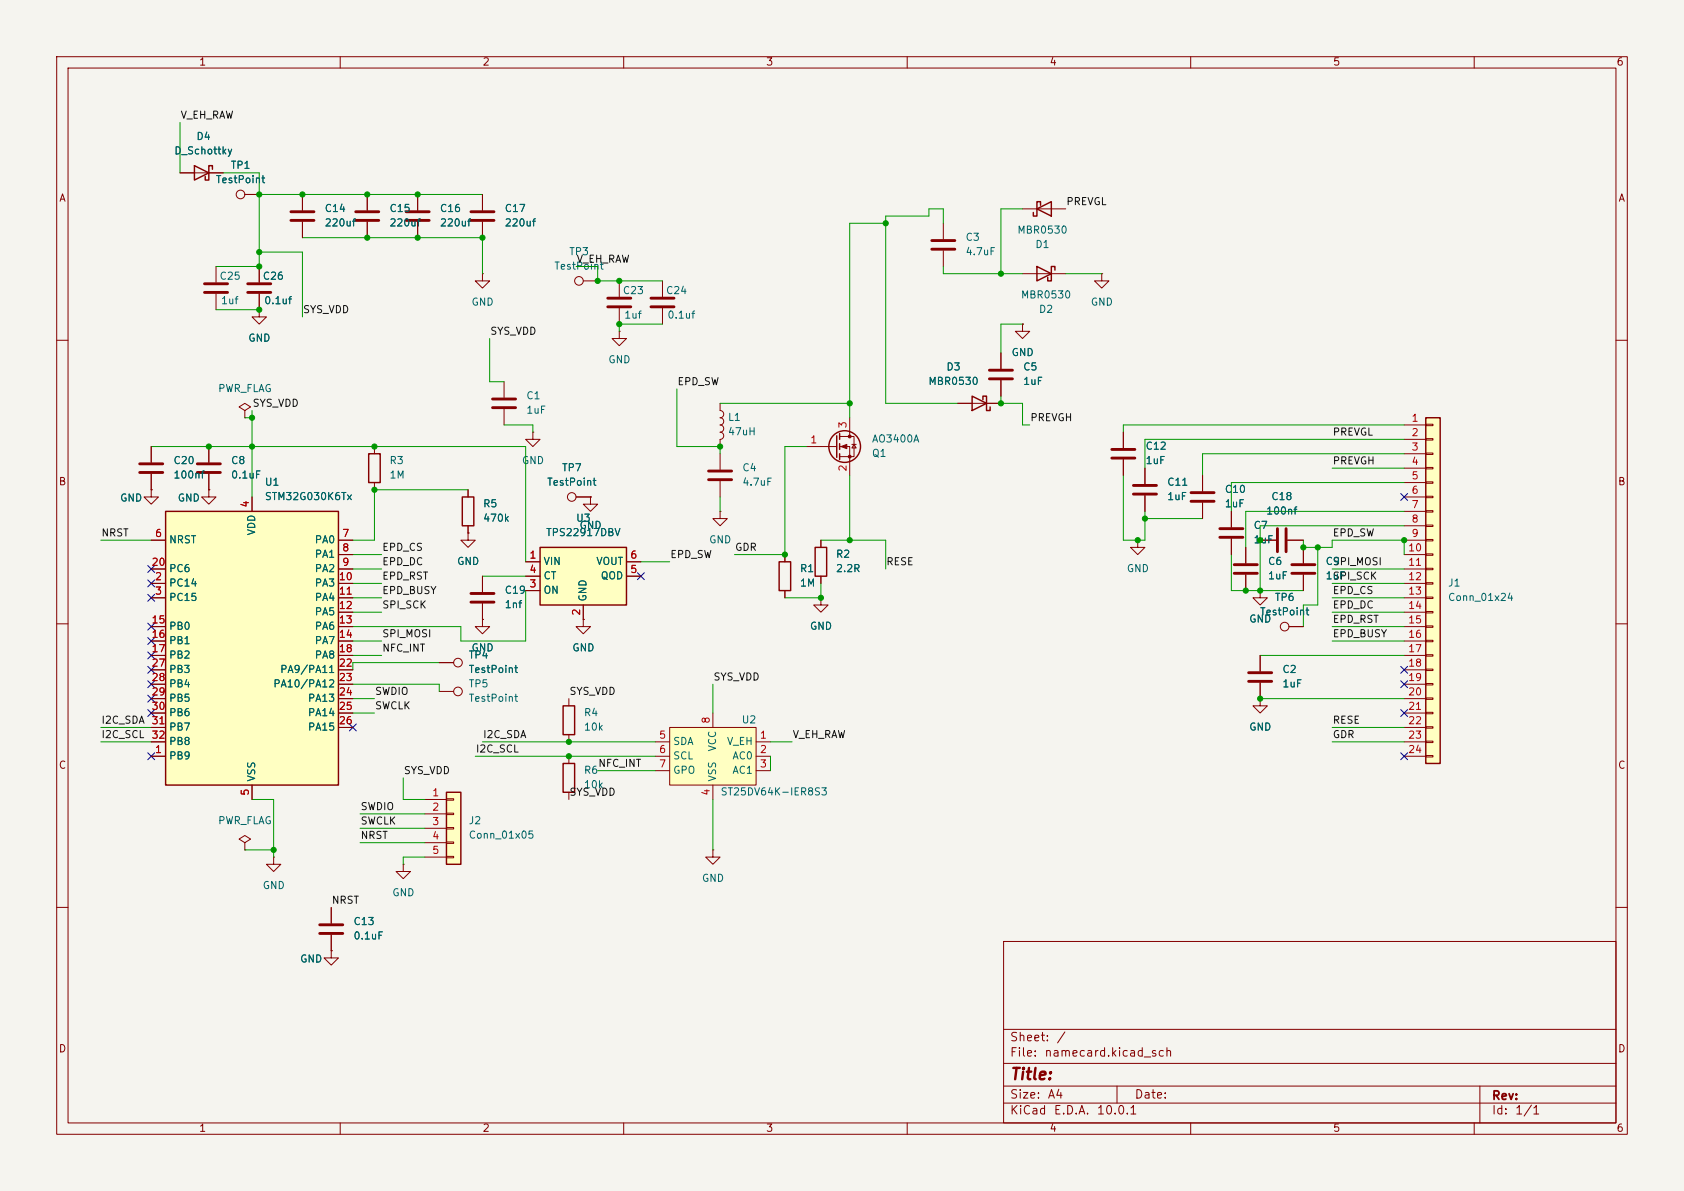
[picture p4: page 1]

Size: A4 | Rev:
KiCad E.D.A. 10.0.1 | Id: 1/1
