soumame/namecard/snapshots/namecard_pre_tps63900_1786407801.pdf

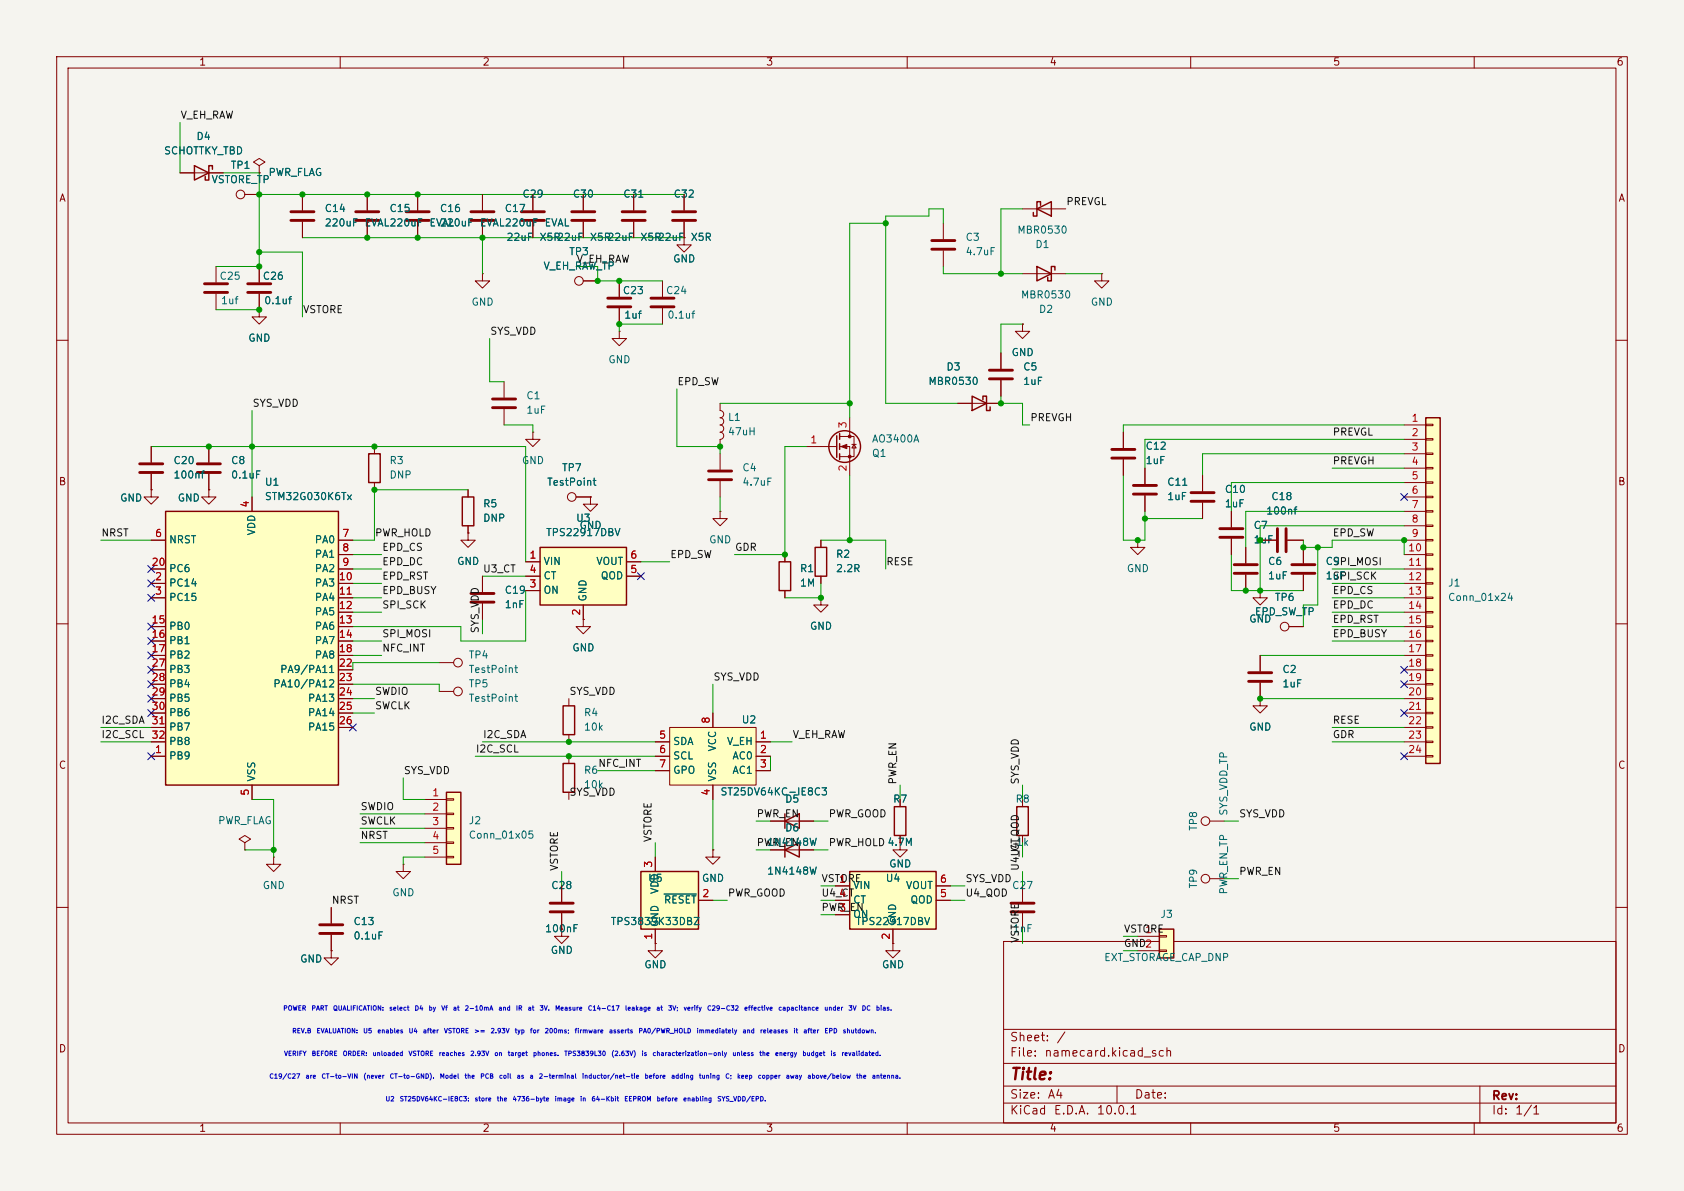
[picture p5: page 1]

POWER PART QUALIFICATION: select D4 by Vf at 2-10mA and IR at 3V. Measure C14-C17 leakage at 3V; verify C29-C32 effective capacitance under 3V DC bias. REV.B EVALUATION: U5 enables U4 after VSTORE >= 2.93V typ for 200ms; firmware asserts PA0/PWR_HOLD immediately and releases it after EPD shutdown. U2 ST25DV64KC-IE8C3: store the 4736-byte image in 64-Kbit EEPROM before enabling SYS_VDD/EPD. VERIFY BEFORE ORDER: unloaded VSTORE reaches 2.93V on target phones. TPS3839L30 (2.63V) is characterization-only unless the energy budget is revalidated. C19/C27 are CT-to-VIN (never CT-to-GND). Model the PCB coil as a 2-terminal inductor/net-tie before adding tuning C; keep copper away above/below the antenna. C13
0.1uF GND

Size: A4 | Rev:
KiCad E.D.A. 10.0.1 | Id: 1/1
