soumame/namecard/snapshots/namecard_revb-konnect-final_1786166376.pdf

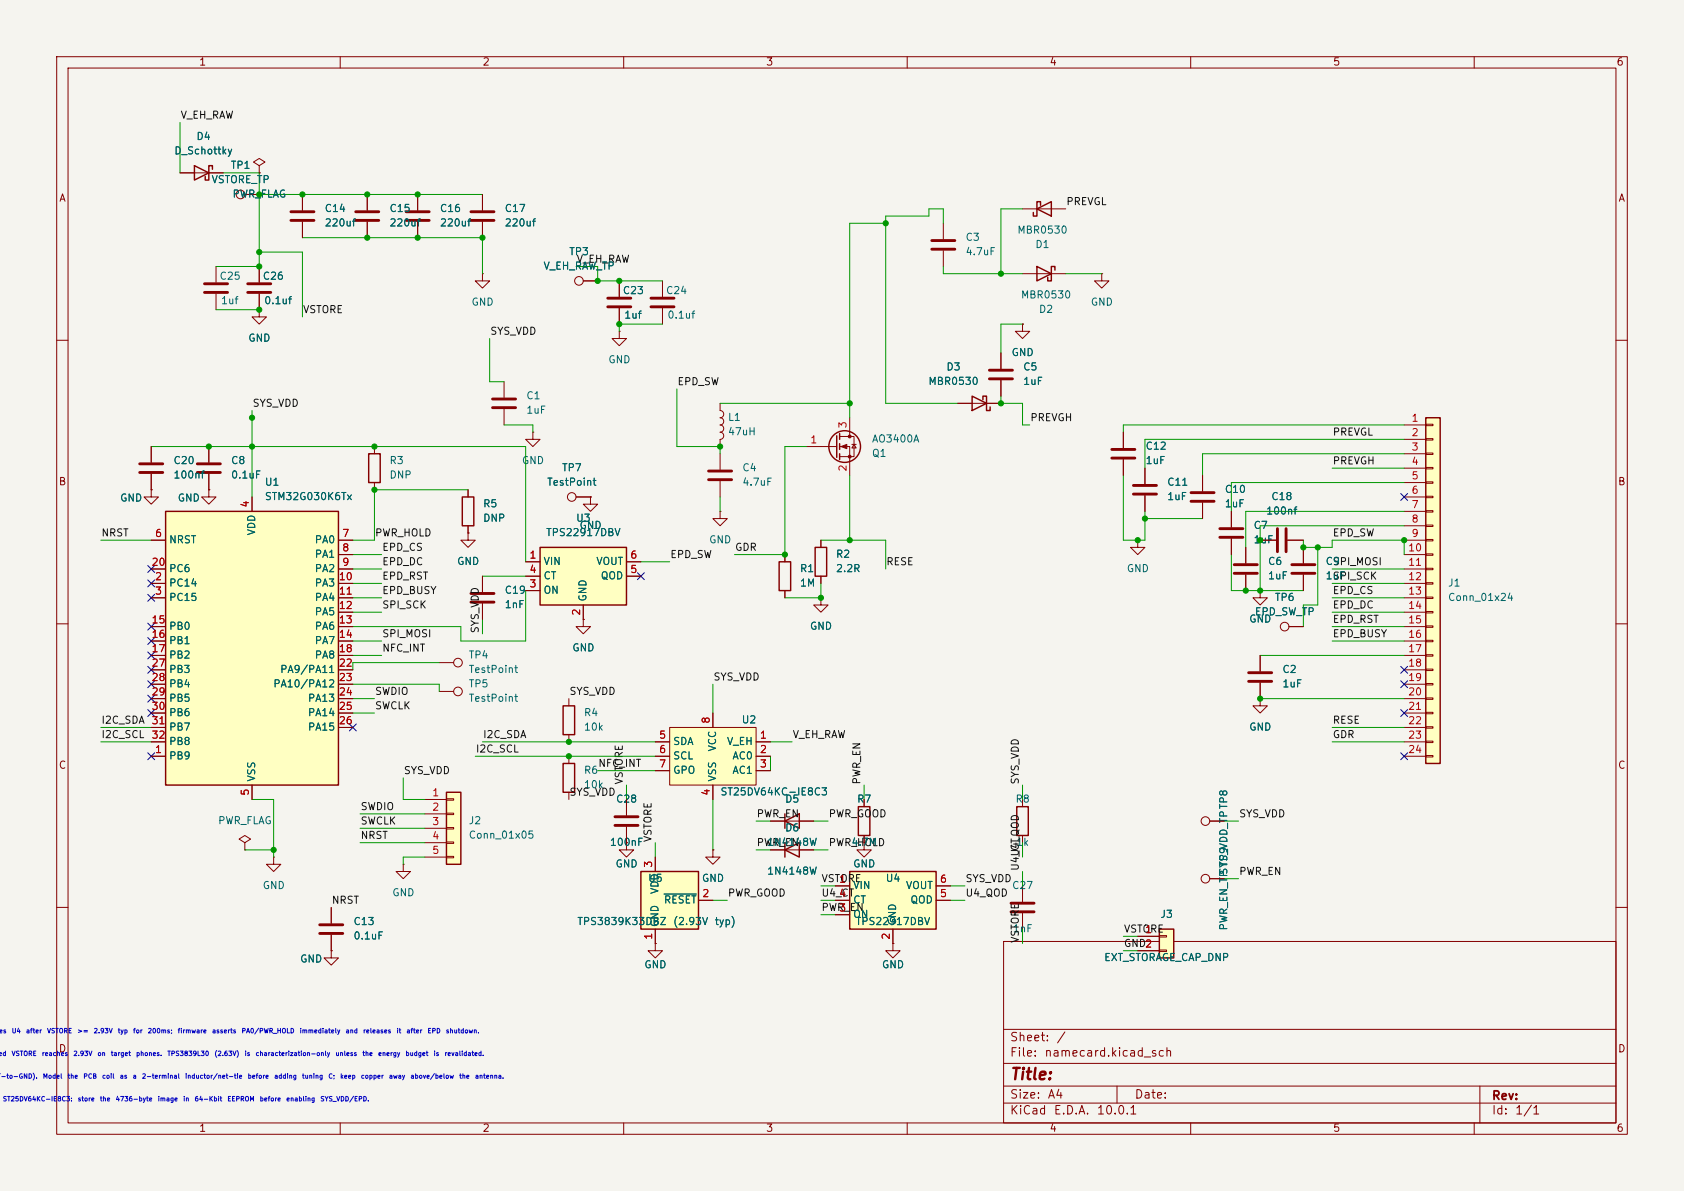
[picture p6: page 1]

Size: A4 | Rev:
KiCad E.D.A. 10.0.1 | Id: 1/1
