soumame/namecard/snapshots/namecard_revb_final.pdf

Size: A4 | Rev:
KiCad E.D.A. 10.0.1 | Id: 1/1
