soumame/namecard/snapshots/namecard_tps63900_added_1786409298.pdf

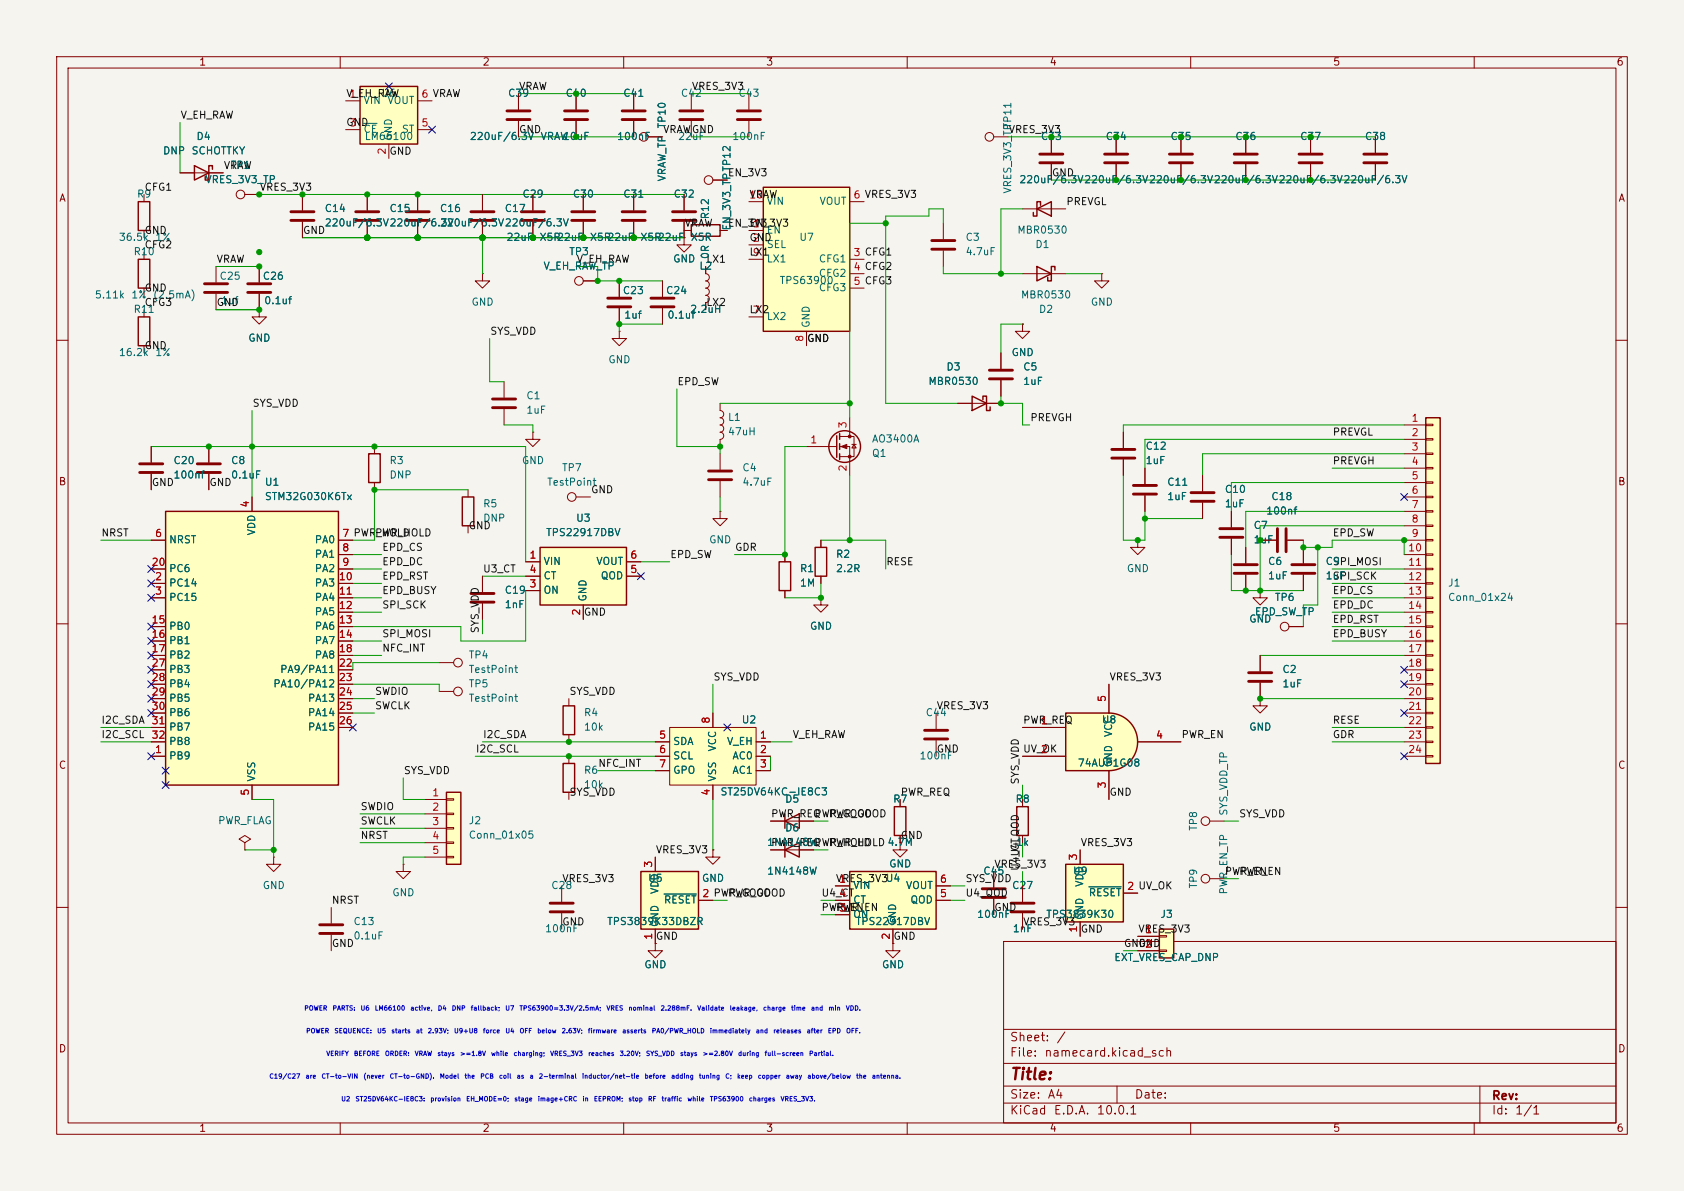
[picture p7: page 1]

SWDIO
SWCLK
GND U4_QOD NRST NRST GND

Size: A4 | Rev:
KiCad E.D.A. 10.0.1 | Id: 1/1
