soumame/namecard/namecard.kicad_pcb

## KiCad design namecard.kicad_pcb (2026-09-04)

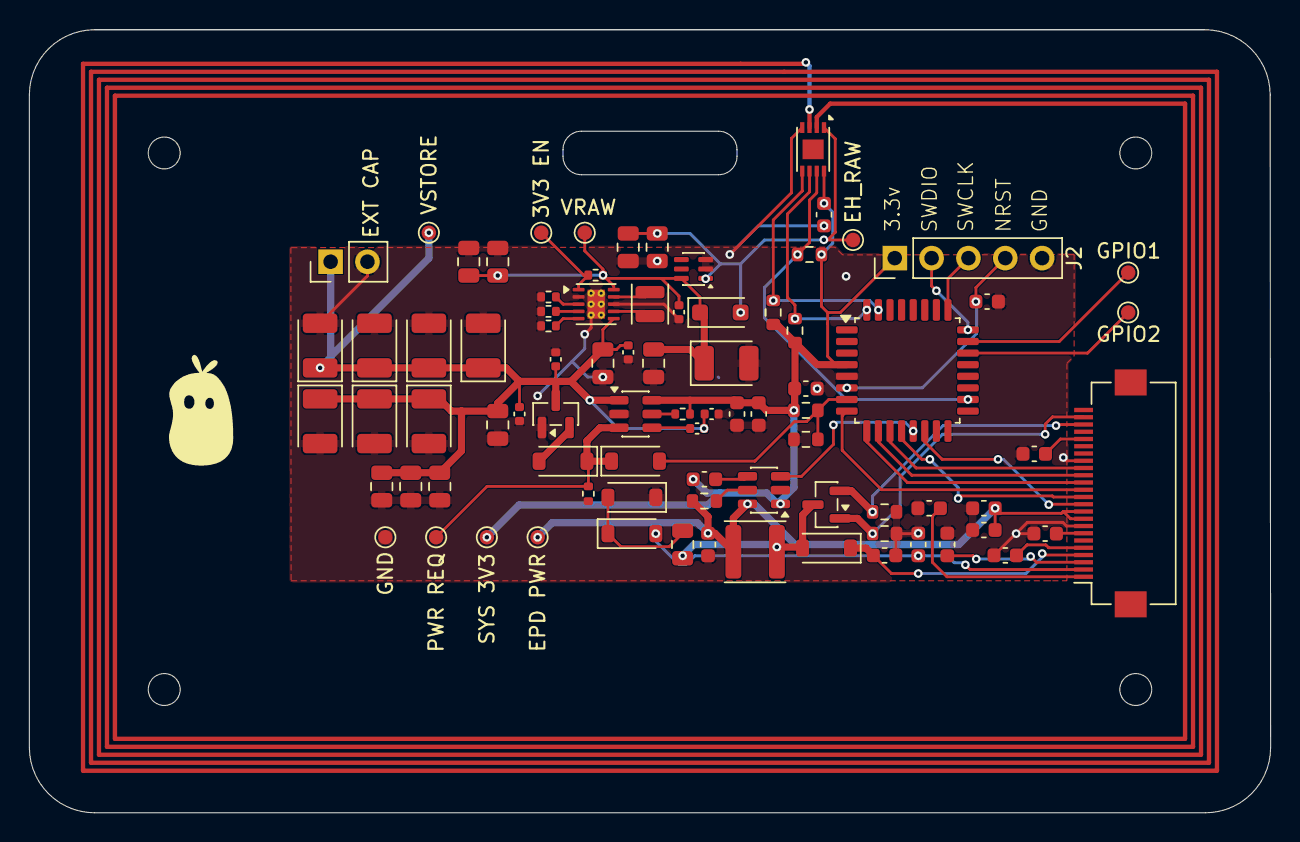
[picture p8: board namecard.kicad_pcb from above]

Board: 2 copper layers, 85.6 x 54.0 mm, 84 parts (0 on the bottom side), 46 nets.

Parts:
3V3 EN: EN_3V3_TP; TestPoint_Pad_D1.0mm
C1, C2, C5, C6, C7, C9, C10, C11, C12: 1uF 50V X5R; C_0603_1608Metric
C3: 4.7uF 25V X5R; C_0805_2012Metric
C4: 4.7uF 16V X5R; C_0603_1608Metric
C8, C13: 0.1uF; C_0603_1608Metric
C14, C15, C16, C17: 220uF/6.3V; CP_EIA-3528-21_Kemet-B
C18, C20: 100nf; C_0603_1608Metric
C19: 1nF; C_0603_1608Metric
C23, C25: 1uf; C_0805_2012Metric
C24, C26: 0.1uf; C_0805_2012Metric
C27: 1nF; C_0402_1005Metric
C28, C41, C43, C44, C45: 100nF; C_0402_1005Metric
C29, C30, C31, C32, C42: 22uF 6.3V X5R; C_0805_2012Metric
C39: 220uF/6.3V VRAW; CP_EIA-3528-21_Kemet-B
C40: 10uF 25V X5R; C_0805_2012Metric
C46, C48, C49: 220uF/6.3V VRES; CP_EIA-3528-21_Kemet-B
C47: 100nF U2 DECOUPLING; C_0603_1608Metric
D1, D2, D3: MBR0530T1G; D_SOD-123
D4: DNP SCHOTTKY; D_SOD-123F
D5, D6: 1N4148W; D_SOD-123
EPD PWR: EPD_SW_TP; TestPoint_Pad_D1.0mm
EXT CAP: EXT_VRES_CAP_DNP; PinHeader_1x02_P2.54mm_Vertical
GND: TestPoint; TestPoint_Pad_D1.0mm
GPIO1, GPIO2: TestPoint; TestPoint_Pad_D1.0mm
J1: Conn_01x24; Hirose_FH12-24S-0.5SH_1x24-1MP_P0.50mm_Horizontal
J2: Conn_01x05; PinHeader_1x05_P2.54mm_Vertical
L1: 47uH; L_APV_ANR4020
L2: 2.2uH; L_Sunlord_SWPA252012S
PWR REQ: PWR_REQ_TP; TestPoint_Pad_D1.0mm
Q1: AO3400A; SOT-23
R1: 1M; R_0603_1608Metric
R2: 2.2R; R_0603_1608Metric
R3: 1M DNP; R_0603_1608Metric
R4, R6: 10k; R_0603_1608Metric
R5: 470k DNP; R_0603_1608Metric
R7: 4.7M; R_0402_1005Metric
R8: 1k; R_0402_1005Metric
R9: 36.5k 1%; R_0402_1005Metric
R10: 5.11k 1% (2.5mA); R_0402_1005Metric
R11: 16.2k 1%; R_0402_1005Metric
R12: 0R; R_0402_1005Metric
R13: 10k GPO PULLUP; R_0603_1608Metric
R14: 1k EPD DISCHARGE; R_0603_1608Metric
SYS 3V3: SYS_VDD_TP; TestPoint_Pad_D1.0mm
TP1: VRES_3V3_TP; TestPoint_Pad_D1.0mm
TP3: V_EH_RAW_TP; TestPoint_Pad_D1.0mm
U1: STM32G031K8T6; LQFP-32_7x7mm_P0.8mm
U2: ST25DV04K-IER6C3; DFN-8-1EP_3x2mm_P0.5mm_EP1.36x1.46mm
U3, U4: TPS22917DBV; SOT-23-6
U5: TPS3839K33DBZR; SOT-23
U6: LM66100; SOT-363_SC-70-6
U7: TPS63900; WSON-10-1EP_2.5x2.5mm_P0.5mm_EP1.2x2mm_ThermalVias
VRAW: VRAW_TP; TestPoint_Pad_D1.0mm

Connections:
/CFG1: R9.1, U7.3 (CFG1)
/CFG2: R10.1, U7.4 (CFG2)
/CFG3: R11.1, U7.5 (CFG3)
/EN_3V3: 3V3 EN.1 (1_1), R12.2, U7.1 (EN)
/EPD_BUSY: J1.16, U1.11 (PA4)
/EPD_CS: J1.13, U1.8 (PA1)
/EPD_DC: J1.14, U1.9 (PA2)
/EPD_RST: J1.15, U1.10 (PA3)
/EPD_SW: C4.1, C9.1, C18.2, EPD PWR.1 (1_1), J1.9, J1.10, L1.2, R14.2, U3.6 (VOUT)
/GDR: J1.23, Q1.1 (G), R1.1
/I2C_SCL: R6.1, U1.32 (PB8), U2.6 (SCL)
/I2C_SDA: R4.1, U1.31 (PB7), U2.5 (SDA)
/LX1: L2.1, U7.9 (LX1)
/LX2: L2.2, U7.7 (LX2)
/NFC_INT: R13.1, U1.18 (PA8), U2.7 (GPO)
/NRST: C13.1, J2.4, U1.6 (PF2-NRST)
/PREVGH: C5.2, D3.1 (K), J1.4
/PREVGL: C11.1, D1.2 (A), J1.2
/PWR_GOOD: D5.2 (A), U5.2 (~RESET)
/PWR_HOLD: D6.2 (A), R3.2, R5.1, U1.7 (PA0)
/PWR_REQ: D5.1 (K), D6.1 (K), PWR REQ.1 (1_1), R7.1, U4.3 (ON)
/RESE: J1.22, Q1.2 (S), R2.1
/SPI_MOSI: J1.11, U1.14 (PA7)
/SPI_SCK: J1.12, U1.12 (PA5)
/SWCLK: J2.3, U1.25 (PA14)
/SWDIO: J2.2, U1.24 (PA13)
/SYS_VDD: C1.1, C8.1, C19.2, C20.1, C47.1, J2.1, R3.1, R4.2, R6.2, R8.1, R13.2, SYS 3V3.1 (1_1), U1.4 (VDD), U2.8 (VCC), U3.1 (VIN), U4.6 (VOUT)
/U3_CT: C19.1, U3.4 (CT)
/U4_CT: C27.1, U4.4 (CT)
/U4_QOD: R8.2, U4.5 (QOD)
/VRAW: C25.1, C26.1, C39.1, C40.1, C41.1, D4.1 (K), R12.1, U6.6 (VOUT), U7.10 (VIN), VRAW.1 (1_1)
/VRES_3V3: C14.1, C15.1, C16.1, C17.1, C27.2, C28.1, C29.1, C30.1, C31.1, C32.1, C42.1, C43.1, C44.1, C45.1, C46.1, C48.1, C49.1, EXT CAP.1, TP1.1 (1_1), U4.1 (VIN), U5.3 (VDD), U7.6 (VOUT)
/V_EH_RAW: C23.1, C24.1, D4.2 (A), TP3.1 (1_1), U2.1 (V_EH), U6.1 (VIN)
GND: C1.2, C2.2, C4.2, C5.1, C6.2, C7.2, C8.2, C9.2, C10.2, C11.2, C12.1, C13.2, C14.2, C15.2, C16.2, C17.2, C18.1, C20.2, C23.2, C24.2, C25.2, C26.2, C28.2, C29.2, C30.2, C31.2, C32.2, C39.2, C40.2, C41.2, C42.2, C43.2, C44.2, C45.2, C46.2, C47.2, C48.2, C49.2, D2.1 (K), EXT CAP.2, GND.1 (1_1), J1.8, J1.17, J2.5, R1.2, R2.2, R5.2, R7.2, R9.2, R10.2, R11.2, U1.5 (VSS), U2.4 (VSS), U3.2 (GND), U4.2 (GND), U5.1 (GND), U6.2 (GND), U6.3 (~CE), U7.2 (SEL), U7.8 (GND), U7.11 (GND)
unnamed: C3.1, D1.1 (K), D2.2 (A)
unnamed: C3.2, D3.2 (A), L1.1, Q1.3 (D)
unnamed: C12.2, J1.1
unnamed: C10.1, J1.3
unnamed: C7.1, J1.5
unnamed: C6.1, J1.7
unnamed: C2.1, J1.20
unnamed: U1.13 (PA6), U3.3 (ON)
unnamed: GPIO2.1 (1_1), U1.22 (PA9/PA11)
unnamed: GPIO1.1 (1_1), U1.23 (PA10/PA12)
unnamed: U2.2 (AC0), U2.3 (AC1)
unnamed: R14.1, U3.5 (QOD)
