soumame/namecard/firmware/Core/Src/main.c

#include "main.h"

#include "app.h"
#include "board.h"
#include "power_monitor.h"

ADC_HandleTypeDef hadc1;
I2C_HandleTypeDef hi2c1;
SPI_HandleTypeDef hspi1;

static void SystemClock_Config(void);
static void MX_ADC1_Init(void);
static void MX_I2C1_Init(void);
static void MX_SPI1_Init(void);

int main(void)
{
    /* Latch the system rail and hold the EPD off before HAL touches GPIOs. */
    board_early_power_safe();
    HAL_Init();
    SystemClock_Config();
    board_gpio_init();
    if (board_power_guard_init() != HAL_OK) {
        Error_Handler();
    }
    MX_ADC1_Init();
    MX_I2C1_Init();
    MX_SPI1_Init();
    if (power_monitor_init(&hadc1) != HAL_OK) {
        Error_Handler();
    }

    app_init();
    while (1) {
        app_process();
    }
}

static void SystemClock_Config(void)
{
    RCC_OscInitTypeDef oscillator = {0};
    RCC_ClkInitTypeDef clocks = {0};
    RCC_PeriphCLKInitTypeDef peripheral = {0};

    oscillator.OscillatorType = RCC_OSCILLATORTYPE_HSI;
    oscillator.HSIState = RCC_HSI_ON;
    oscillator.HSIDiv = RCC_HSI_DIV1;
    oscillator.HSICalibrationValue = RCC_HSICALIBRATION_DEFAULT;
    oscillator.PLL.PLLState = RCC_PLL_NONE;
    if (HAL_RCC_OscConfig(&oscillator) != HAL_OK) {
        Error_Handler();
    }

    clocks.ClockType = RCC_CLOCKTYPE_HCLK | RCC_CLOCKTYPE_SYSCLK | RCC_CLOCKTYPE_PCLK1;
    clocks.SYSCLKSource = RCC_SYSCLKSOURCE_HSI;
    clocks.AHBCLKDivider = RCC_SYSCLK_DIV2;
    clocks.APB1CLKDivider = RCC_HCLK_DIV1;
    if (HAL_RCC_ClockConfig(&clocks, FLASH_LATENCY_0) != HAL_OK) {
        Error_Handler();
    }

    /* I2C1 uses HSI16 directly; the CPU and SPI1 run from the 8 MHz HCLK. */
    peripheral.PeriphClockSelection = RCC_PERIPHCLK_I2C1;
    peripheral.I2c1ClockSelection = RCC_I2C1CLKSOURCE_HSI;
    if (HAL_RCCEx_PeriphCLKConfig(&peripheral) != HAL_OK) {
        Error_Handler();
    }
}

static void MX_ADC1_Init(void)
{
    hadc1.Instance = ADC1;
    hadc1.Init.ClockPrescaler = ADC_CLOCK_SYNC_PCLK_DIV2;
    hadc1.Init.Resolution = ADC_RESOLUTION_12B;
    hadc1.Init.DataAlign = ADC_DATAALIGN_RIGHT;
    hadc1.Init.ScanConvMode = ADC_SCAN_DISABLE;
    hadc1.Init.EOCSelection = ADC_EOC_SINGLE_CONV;
    hadc1.Init.LowPowerAutoWait = DISABLE;
    hadc1.Init.LowPowerAutoPowerOff = ENABLE;
    hadc1.Init.ContinuousConvMode = DISABLE;
    hadc1.Init.NbrOfConversion = 1U;
    hadc1.Init.DiscontinuousConvMode = DISABLE;
    hadc1.Init.ExternalTrigConv = ADC_SOFTWARE_START;
    hadc1.Init.ExternalTrigConvEdge = ADC_EXTERNALTRIGCONVEDGE_NONE;
    hadc1.Init.DMAContinuousRequests = DISABLE;
    hadc1.Init.Overrun = ADC_OVR_DATA_PRESERVED;
    hadc1.Init.SamplingTimeCommon1 = ADC_SAMPLETIME_160CYCLES_5;
    hadc1.Init.SamplingTimeCommon2 = ADC_SAMPLETIME_160CYCLES_5;
    hadc1.Init.OversamplingMode = DISABLE;
    hadc1.Init.TriggerFrequencyMode = ADC_TRIGGER_FREQ_LOW;
    if (HAL_ADC_Init(&hadc1) != HAL_OK) {
        Error_Handler();
    }
}

static void MX_I2C1_Init(void)
{
    hi2c1.Instance = I2C1;
    /* CubeMX timing for 16 MHz I2C kernel clock, Fast-mode 400 kHz. */
    hi2c1.Init.Timing = 0x0010061AU;
    hi2c1.Init.OwnAddress1 = 0U;
    hi2c1.Init.AddressingMode = I2C_ADDRESSINGMODE_7BIT;
    hi2c1.Init.DualAddressMode = I2C_DUALADDRESS_DISABLE;
    hi2c1.Init.OwnAddress2 = 0U;
    hi2c1.Init.OwnAddress2Masks = I2C_OA2_NOMASK;
    hi2c1.Init.GeneralCallMode = I2C_GENERALCALL_DISABLE;
    hi2c1.Init.NoStretchMode = I2C_NOSTRETCH_DISABLE;
    if (HAL_I2C_Init(&hi2c1) != HAL_OK) {
        Error_Handler();
    }
    if (HAL_I2CEx_ConfigAnalogFilter(&hi2c1, I2C_ANALOGFILTER_ENABLE) != HAL_OK) {
        Error_Handler();
    }
    if (HAL_I2CEx_ConfigDigitalFilter(&hi2c1, 0U) != HAL_OK) {
        Error_Handler();
    }
}

static void MX_SPI1_Init(void)
{
    hspi1.Instance = SPI1;
    hspi1.Init.Mode = SPI_MODE_MASTER;
    hspi1.Init.Direction = SPI_DIRECTION_1LINE;
    hspi1.Init.DataSize = SPI_DATASIZE_8BIT;
    hspi1.Init.CLKPolarity = SPI_POLARITY_LOW;
    hspi1.Init.CLKPhase = SPI_PHASE_1EDGE;
    hspi1.Init.NSS = SPI_NSS_SOFT;
    hspi1.Init.BaudRatePrescaler = SPI_BAUDRATEPRESCALER_2;
    hspi1.Init.FirstBit = SPI_FIRSTBIT_MSB;
    hspi1.Init.TIMode = SPI_TIMODE_DISABLE;
    hspi1.Init.CRCCalculation = SPI_CRCCALCULATION_DISABLE;
    hspi1.Init.CRCPolynomial = 7U;
    hspi1.Init.CRCLength = SPI_CRC_LENGTH_DATASIZE;
    hspi1.Init.NSSPMode = SPI_NSS_PULSE_DISABLE;
    if (HAL_SPI_Init(&hspi1) != HAL_OK) {
        Error_Handler();
    }
    board_epd_bus_hiz();
}

void Error_Handler(void)
{
    __disable_irq();
    board_epd_power_off();
    board_power_hold_release();
    while (1) {
    }
}
