soumame/namecard/firmware/Core/Src/board.c

#include "board.h"

static volatile bool epd_busy_edge;
static volatile bool nfc_gpo_edge;
static volatile bool brownout_latched;

void board_early_power_safe(void)
{
    RCC->IOPENR |= RCC_IOPENR_GPIOAEN;
    (void)RCC->IOPENR;

    /* Preload PA0 high before enabling its output driver so the TPS22917
       self-hold path cannot glitch low.  PA6 is preloaded low to keep the EPD
       rail off throughout C/HAL initialization. */
    GPIOA->BSRR = PWR_HOLD_PIN | ((uint32_t)EPD_POWER_EN_PIN << 16U);
    GPIOA->OTYPER &= ~(GPIO_OTYPER_OT0 | GPIO_OTYPER_OT6);
    GPIOA->PUPDR &= ~((3UL << (0U * 2U)) | (3UL << (6U * 2U)));
    GPIOA->MODER =
        (GPIOA->MODER & ~((3UL << (0U * 2U)) | (3UL << (6U * 2U)))) |
        (1UL << (0U * 2U)) | (1UL << (6U * 2U));
}

void board_epd_bus_hiz(void)
{
    GPIO_InitTypeDef gpio = {0};
    gpio.Pin = EPD_CS_PIN | EPD_DC_PIN | EPD_RST_PIN | EPD_SCK_PIN | EPD_MOSI_PIN;
    gpio.Mode = GPIO_MODE_ANALOG;
    gpio.Pull = GPIO_NOPULL;
    HAL_GPIO_Init(GPIOA, &gpio);
}

void board_epd_bus_active(void)
{
    GPIO_InitTypeDef gpio = {0};

    HAL_GPIO_WritePin(GPIOA, EPD_CS_PIN, GPIO_PIN_SET);
    HAL_GPIO_WritePin(GPIOA, EPD_DC_PIN, GPIO_PIN_RESET);
    HAL_GPIO_WritePin(GPIOA, EPD_RST_PIN, GPIO_PIN_SET);
    gpio.Pin = EPD_CS_PIN | EPD_DC_PIN | EPD_RST_PIN;
    gpio.Mode = GPIO_MODE_OUTPUT_PP;
    gpio.Pull = GPIO_NOPULL;
    gpio.Speed = GPIO_SPEED_FREQ_LOW;
    HAL_GPIO_Init(GPIOA, &gpio);

    gpio.Pin = EPD_SCK_PIN | EPD_MOSI_PIN;
    gpio.Mode = GPIO_MODE_AF_PP;
    gpio.Pull = GPIO_NOPULL;
    gpio.Speed = GPIO_SPEED_FREQ_LOW;
    gpio.Alternate = GPIO_AF0_SPI1;
    HAL_GPIO_Init(GPIOA, &gpio);
}

void board_gpio_init(void)
{
    __HAL_RCC_GPIOA_CLK_ENABLE();
    __HAL_RCC_GPIOB_CLK_ENABLE();

    HAL_GPIO_WritePin(PWR_HOLD_PORT, PWR_HOLD_PIN, GPIO_PIN_SET);
    HAL_GPIO_WritePin(EPD_POWER_EN_PORT, EPD_POWER_EN_PIN, GPIO_PIN_RESET);
    GPIO_InitTypeDef gpio = {0};
    gpio.Pin = PWR_HOLD_PIN | EPD_POWER_EN_PIN;
    gpio.Mode = GPIO_MODE_OUTPUT_PP;
    gpio.Pull = GPIO_NOPULL;
    gpio.Speed = GPIO_SPEED_FREQ_LOW;
    HAL_GPIO_Init(EPD_POWER_EN_PORT, &gpio);

    gpio.Pin = EPD_BUSY_PIN;
    gpio.Mode = GPIO_MODE_IT_RISING_FALLING;
    gpio.Pull = GPIO_NOPULL;
    HAL_GPIO_Init(EPD_BUSY_PORT, &gpio);

    gpio.Pin = NFC_GPO_PIN;
    gpio.Mode = GPIO_MODE_IT_RISING_FALLING;
    gpio.Pull = GPIO_NOPULL;
    HAL_GPIO_Init(NFC_GPO_PORT, &gpio);

    board_epd_bus_hiz();
    HAL_NVIC_SetPriority(EXTI4_15_IRQn, 2U, 0U);
    HAL_NVIC_EnableIRQ(EXTI4_15_IRQn);
}

HAL_StatusTypeDef board_power_guard_init(void)
{
    PWR_PVDTypeDef pvd = {0};
    pvd.PVDLevel = PWR_PVDLEVEL_4;
    pvd.Mode = PWR_PVD_MODE_IT_FALLING;

    brownout_latched = false;
    __HAL_PWR_PVD_EXTI_CLEAR_RISING_FLAG();
    __HAL_PWR_PVD_EXTI_CLEAR_FALLING_FLAG();
    if (HAL_PWREx_ConfigPVD(&pvd) != HAL_OK) {
        return HAL_ERROR;
    }
    HAL_NVIC_SetPriority(PVD_IRQn, 0U, 0U);
    HAL_NVIC_EnableIRQ(PVD_IRQn);
    HAL_PWREx_EnablePVD();
    HAL_Delay(1U); /* PVD startup is at most a few microseconds. */
    if (__HAL_PWR_GET_FLAG(PWR_FLAG_PVDO)) {
        board_brownout_shutdown_isr();
        return HAL_ERROR;
    }
    return HAL_OK;
}

void board_power_hold_enable(void)
{
    HAL_GPIO_WritePin(PWR_HOLD_PORT, PWR_HOLD_PIN, GPIO_PIN_SET);
}

void board_power_hold_release(void)
{
    HAL_GPIO_WritePin(PWR_HOLD_PORT, PWR_HOLD_PIN, GPIO_PIN_RESET);
}

void board_brownout_shutdown_isr(void)
{
    const uint32_t epd_bus_mode_mask =
        (3UL << (1U * 2U)) | (3UL << (2U * 2U)) |
        (3UL << (3U * 2U)) | (3UL << (5U * 2U)) |
        (3UL << (7U * 2U));

    brownout_latched = true;
    GPIOA->BSRR = (uint32_t)EPD_POWER_EN_PIN << 16U;
    GPIOA->MODER |= epd_bus_mode_mask; /* Analog/no-pull: no EPD back-power. */
    GPIOA->BSRR = (uint32_t)PWR_HOLD_PIN << 16U;
    __DSB();
}

bool board_brownout_detected(void)
{
    return brownout_latched;
}

void board_epd_power_on(void)
{
    if (!brownout_latched) {
        HAL_GPIO_WritePin(EPD_POWER_EN_PORT, EPD_POWER_EN_PIN, GPIO_PIN_SET);
    }
}

void board_epd_power_off(void)
{
    board_epd_bus_hiz();
    HAL_GPIO_WritePin(EPD_POWER_EN_PORT, EPD_POWER_EN_PIN, GPIO_PIN_RESET);
}

bool board_epd_is_busy(void)
{
    return HAL_GPIO_ReadPin(EPD_BUSY_PORT, EPD_BUSY_PIN) == GPIO_PIN_SET;
}

void board_note_epd_busy_edge(void)
{
    epd_busy_edge = true;
}

void board_note_nfc_gpo_edge(void)
{
    nfc_gpo_edge = true;
}

bool board_take_epd_busy_edge(void)
{
    const bool value = epd_busy_edge;
    epd_busy_edge = false;
    return value;
}

bool board_take_nfc_gpo_edge(void)
{
    const bool value = nfc_gpo_edge;
    nfc_gpo_edge = false;
    return value;
}
