soumame/namecard/(commit log)

2026-04-19 Initial commit: KiCad project start
    [namecard.kicad_pcb, namecard.kicad_sch]
2026-04-19 電源回路周りの調整
    [namecard.kicad_sch]
2026-04-25 基盤配置の調整
    [namecard.kicad_pcb, namecard.kicad_sch]
2026-04-25 電源の太さの調整
    [namecard.kicad_pcb]
2026-04-25 v2 production
    [namecard.kicad_pcb, namecard.kicad_sch]
2026-05-02 V3向けの変更:LEDの向きを直したり
    [namecard.kicad_pcb, namecard.kicad_sch]
2026-05-12 wip: 電源周りの回路図を更新
    [namecard.kicad_pcb, namecard.kicad_sch]
2026-05-13 wip: v3向けに配置を更新
    [namecard.kicad_pcb]
2026-05-14 wip: 配置を更新
    [namecard.kicad_pcb, namecard.kicad_sch]
2026-08-06 DS_Storeをignore
2026-08-08 v3向けの検証
    [namecard.kicad_sch]
2026-08-26 V5: release firmware, hardware, software
    [namecard.kicad_pcb]
2026-08-27 implement few adjustment on footprints/circuit, update readme
    [namecard.kicad_pcb, namecard.kicad_sch]
2026-09-04 upload cpl and BOM
    [bom.xls, namecard_v3_bom.csv, namecard_v3_designators.csv, namecard_v3_positions.csv, namecard_v4_bom.csv, namecard_v4_designators.csv, namecard_v4_positions.csv, namecard_v5_bom.csv]
2026-09-04 feat: Add production files for Maker Faire Tokyo 2026, including BOM, CPL, and Gerber data
    [jlcpcb_purchased_parts_30pcs.xls, namecard.kicad_pcb, namecard.kicad_sch, namecard_v5_bom.csv, namecard_v5_bom.xlsx, namecard_v5_positions.csv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]
2026-09-05 fix: wait for harvested power before enabling mailbox
2026-09-08 iOS development (#6)
    * wip: iOS app development / Android app fix
    * UI fix & preparation for testflight release
    [namecard_v2_bom.csv, namecard_v2_designators.csv, namecard_v2_positions.csv, namecard_v5_bom.csv, namecard_v5_designators.csv, namecard_v5_positions.csv]
2026-09-23 feat: Implement NFC dispatch handling and logging improvements (#18)
    * feat: Implement NFC dispatch handling and logging improvements
    Android ClientアプリでFW18 Errorが確認される問題
    Fixes #17
    * fix(ios): include fallback glyph overhang in selection bounds
    * test(ios): retry missed paste menu taps once
